06Felix06/Stecktec-EIC_GitHub/docs/Auslageblatt.pdf

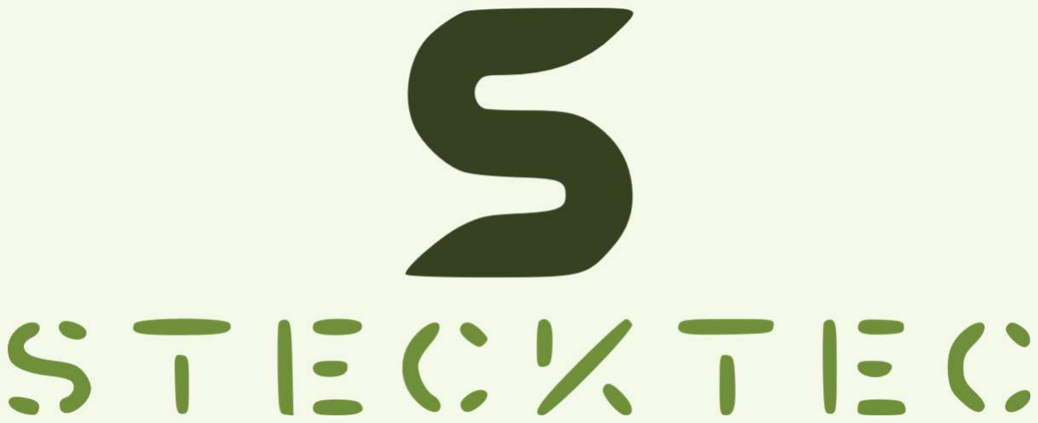
[picture p14: figure]

# Maturaprojekt 2025

### Felix Steck 5BEL – Elektronik

- Sensorbasiert: Misst Bodenfeuchte, Temperatur und Luftfeuchtigkeit
- Automatisiert: Steuert die Bewässerung gezielt nach Bedarf
- Mobile App: Einfache Steuerung und Anzeige per Smartphone
- Modular: Je nach Bedarf durch verschiedene Module erweiterbar

# Bewässerungssteuerung

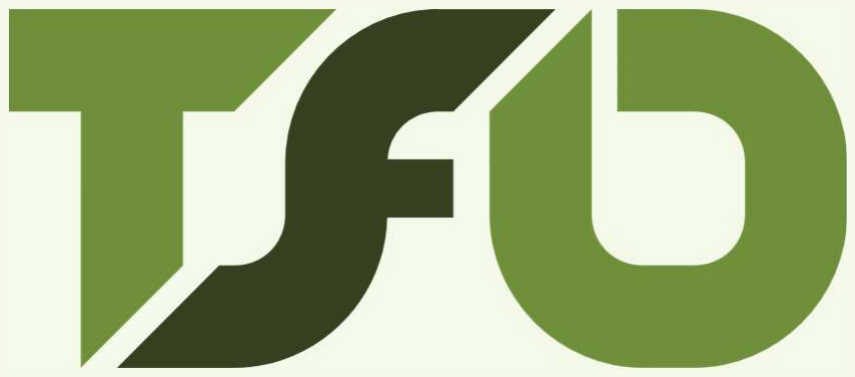
[picture p15: figure]
