06Felix06/Stecktec-EIC_GitHub/docs/projektmanagement/Blockschaltbild.pdf

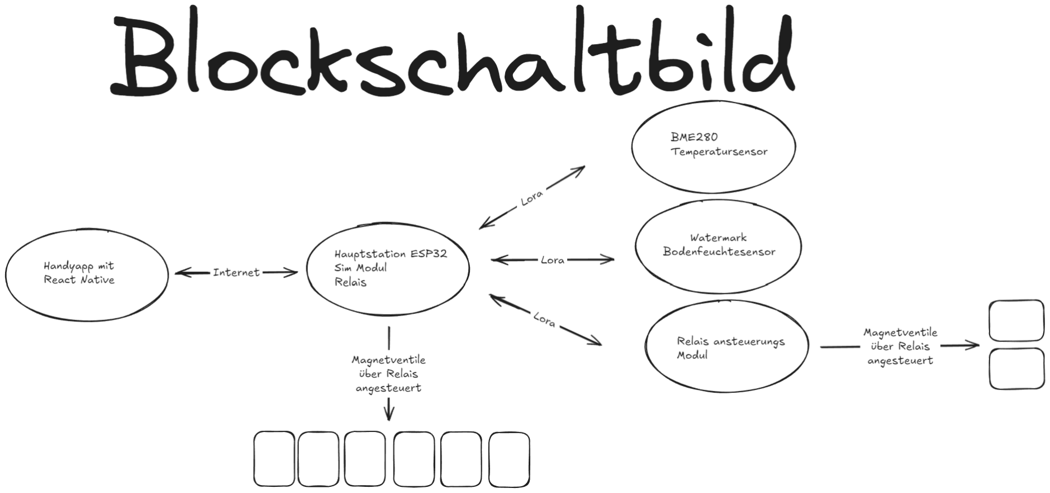
[picture p64: page 1]
