06Felix06/Stecktec-EIC_GitHub/hardware/01_Hauptplatine_V2/production/bom.csv

Designator | Footprint | Quantity | Value | LCSC Part #
Battery1 | BAT-TH_L77.0-W39.9_BH-18650-A1BJ021 | 1 | BH-18650-A1BJ021 | C20606804
C1, C10, C2, C4, C5, C6, C8, Cbyp1 | 0805 | 8 | 100nF
C3 | 0805 | 1 | 10µF
Ccomp1 | 0805 | 1 | 1.8nF
Ccomp2, Cfilt1 | 0805 | 2 | 33nF
Cin1, Cout1, Cout2 | CAP-TH_BD6.3-P2.50-D1.0-FD | 3 | 120µ | C442997
D1, D10, D11, D12, D13, D14, D15, D16, D17, D2, D3, D4, D5, D6, D7, D8 | SMA_L4.3-W2.5-LS5.0-RD | 16 | Diode | C727081
D30 | 0805 | 1 | kopplungLED
D31 | 0805 | 1 | PWR_LED
D9 | SMC_L7.1-W6.2-LS8.1-RD | 1 | B540C-13-F | C72264
J1 | PinSocket_1x07_P2.54mm_Vertical | 1 | LoraModule
J15 | PinHeader_1x02_P2.54mm_Vertical | 1 | Jumper_LED
J17 | PinSocket_1x03_P2.54mm_Vertical | 1 | Befestigung
J2 | PinHeader_2x04_P2.54mm_Vertical | 1 | Bootload
J20, J4 | PinSocket_1x12_P2.54mm_Vertical | 2 | Erweiterung_Ventile1
J3 | PinSocket_1x06_P2.54mm_Vertical | 1 | DS3231_RTC
J5 | PinSocket_1x07_P2.54mm_Vertical | 1 | Sim7000
J7 | PinSocket_1x06_P2.54mm_Vertical | 1 | USB_IN_Bat_volt
J8 | PinSocket_1x06_P2.54mm_Vertical | 1 | Bat_Solar_Vout
JP4, JP5, JP6 | SolderJumper-2_P1.3mm_Open_Pad1.0x1.5mm | 3 | SolderJumper_2_Open
L1 | IND-SMD_L6.6-W6.4 | 1 | XAL6030 | C19191693
R1, R6, R7, R8 | 0805 | 4 | 10k
R2, R3 | 0805 | 2 | 470k
R4, R5 | 0805 | 2 | 4.7k
RV_LED1, RV_LED2, Rfb1 | 0805 | 3 | 1k
Rcomp1 | 0805 | 1 | 2.94k
Reset1 | SW-SMD_4P-L6.2-W6.2-P4.50-LS8.6 | 1 | Reset | C2909692
Rfadj1 | 0805 | 1 | 26.7k
Rfb2 | 0805 | 1 | 8.45k
Rfilt1 | 0805 | 1 | 100
Rsense1 | 0805 | 1 | 5mΩ
Solar1 | CONN-TH_B2B-PH-K-S | 1 | B2B-PH-K-S(LF)(SN) | C131337
TP1 | TPSteckFelix | 1 | tp_Bat+
TP2 | TPSteckFelix | 1 | tp_Solar+
TP3 | TPSteckFelix | 1 | tp_+5V
TP4 | TPSteckFelix | 1 | tp_+3V3
TP5 | TPSteckFelix | 1 | tpGND
TP6 | TPSteckFelix | 1 | tp_+12V
U1 | TQFP-32_L7.0-W7.0-P0.80-LS9.0-BL | 1 | ATMEGA328P-AU | C14877
U10, U2 | HSOP-20_L15.9-W11.0-P1.27-LS14.2-BL-EP | 2 | XL298P | C17179540
U11 | SOIC-8_L5.0-W4.0-P1.27-LS6.0-BL | 1 | LM358
U12 | SSOP-28_L10.2-W5.3-P0.65-LS7.8-BL | 1 | MCP23S17-E/SS | C148009
U3 | CONN-TH_B5B-PH-K-S-LF-SN | 1 | Vent1 | C157993
U4 | VSSOP-8_L3.0-W3.0-P0.65-LS5.0-BL | 1 | LM3478MM | C9404
U5 | SOP-8_L4.9-W3.9-P1.27-LS6.0-BL | 1 | IRF7807 | C5350865
U6 | CONN-TH_B5B-PH-K-S-LF-SN | 1 | Vent2 | C157993
U7 | CONN-TH_B5B-PH-K-S-LF-SN | 1 | Vent3 | C157993
U8 | SOIC-16_L9.9-W3.9-P1.27-LS6.0-BL | 1 | CD4052B | C5356105
U9 | CONN-TH_B5B-PH-K-S-LF-SN | 1 | Vent4 | C157993
X1 | OSC-SMD_3P-L3.2-W1.3-P1.20-L | 1 | CSTNE16M0V53Z000R0 | C783275
