06Felix06/Stecktec-EIC_GitHub/hardware/03_Magnetventilsteuerung/production/bom.csv

Designator | Footprint | Quantity | Value | LCSC Part #
C1, Cbyp1 | 0805 | 2 | 100nF
CN1 | CONN-TH_B3B-PH-K-S | 1 | SENS_Vent1 | C131339
CN2 | CONN-TH_B3B-PH-K-S | 1 | SENS_Vent2 | C131339
Ccomp1, Cfilt1 | 0805 | 2 | 33nF
Ccomp2 | 0805 | 1 | 1.8nF
Cin1, Cout1, Cout2 | CAP-TH_BD6.3-P2.50-D1.0-FD | 3 | 120µ | C442997
D1, D2, D3, D4, D5, D6, D7, D8 | SMA_L4.3-W2.5-LS5.0-RD | 8 | 1N4007 | C727081
D9 | SMC_L7.1-W6.2-LS8.1-RD | 1 | B540C-13-F | C72264
J1, J2 | PinHeader_1x10_P2.54mm_Vertical | 2 | PINHD_1x10_Male
L1 | IND-SMD_L6.6-W6.4 | 1 | XAL6030 | C19191693
Rcomp1 | 0805 | 1 | 2.94k
Rfadj1 | 0805 | 1 | 26.7k
Rfb1 | 0805 | 1 | 1k
Rfb2 | 0805 | 1 | 8.45k
Rfilt1 | 0805 | 1 | 100
Rsense1 | 0805 | 1 | 5mΩ
U1 | HSOP-20_L15.9-W11.0-P1.27-LS14.2-BL-EP | 1 | XL298P | C17179540
U2 | CONN-TH_2P-P5.00_MX127-5.0-02P-GN01-CU-Y-A | 1 | Vent1 | C5188440
U3 | CONN-TH_2P-P5.00_MX127-5.0-02P-GN01-CU-Y-A | 1 | Vent2 | C5188440
U4 | VSSOP-8_L3.0-W3.0-P0.65-LS5.0-BL | 1 | LM3478MM | C9404
U5 | SOP-8_L4.9-W3.9-P1.27-LS6.0-BL | 1 | IRF7807 | C5350865
