06Felix06/Stecktec-EIC_GitHub/hardware/04_Solarversorgung_V2/production/bom.csv

Designator | Footprint | Quantity | Value | LCSC Part #
C1, C4, C6 | 0805 | 3 | 10µ
C2, C5 | 0805 | 2 | 100n
C3 | 0805 | 1 | 22µ
C7 | 0805 | 1 | 47µ
C8 | 0805 | 1 | 4.7µF
C9 | 0805 | 1 | 22µF
D1 | SMA_L4.3-W2.6-LS5.2-RD | 1 | SS34_C8678 | C8678
D2 | 0805 | 1 | STDBY
D4 | 0805 | 1 | CHRG
J1 | PinHeader_1x02_P2.54mm_Vertical | 1 | LED_JMP
J5 | PinHeader_1x06_P2.54mm_Vertical | 1 | USB_IN_Bat_volt_3.3
J7 | PinHeader_1x06_P2.54mm_Vertical | 1 | Bat_Solar_Vout
L1 | IND-SMD_L4.5-W4.1_SL0420 | 1 | SL0420-100M | C22463809
L2 | IND-SMD_L7.2-W6.6_GPSR07X0 | 1 | CYA0630-2.2UH | C5189746
R1, R2 | 0805 | 2 | 1k
R3 | 0805 | 1 | 2k
R4 | 0805 | 1 | 300mΩ
R5 | RES-ADJ-SMD_VG039NCH | 1 | 200k | C128558
SW1 | SW-SMD_MK-12C02-G025 | 1 | MK-12C02-G025 | C778186
U1 | ESOP-8_L4.9-W3.9-P1.27-LS6.0-BL-EP | 1 | TP5400 | C2891434
U2 | SOT-23-5_L3.0-W1.7-P0.95-LS2.8-BR | 1 | TLV62569DBVR | C141836
