06Felix06/Stecktec-EIC_GitHub/hardware/3D-Gehaeuse/Programmiergeraet/V1DeckelCase.stl

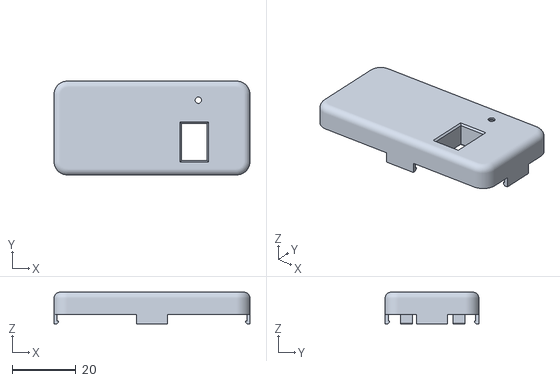
[picture p65: CAD file, 2026-11-07]
hardware/3D-Gehaeuse/Programmiergeraet/V1DeckelCase.stl
61.4 x 29.4 x 10.0
