06Felix06/Stecktec-EIC_GitHub/hardware/3D-Gehaeuse/V2_GehäuseSensor_Body.stl

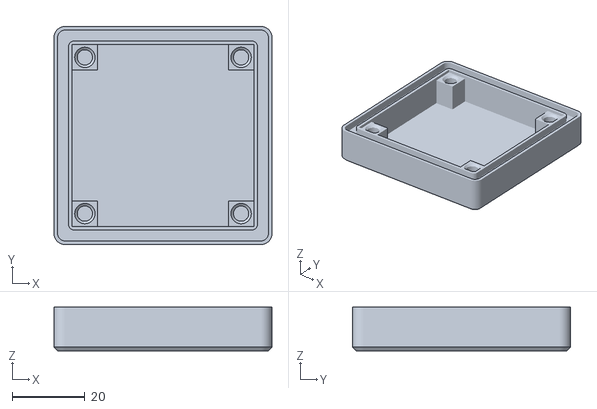
[picture p66: CAD file, 2026-11-07]
hardware/3D-Gehaeuse/V2_GehäuseSensor_Body.stl
60.0 x 60.0 x 12.0
