06Felix06/Stecktec-EIC_GitHub/hardware/3D-Gehaeuse/Programmiergeraet/V2Reset Drucker.stl

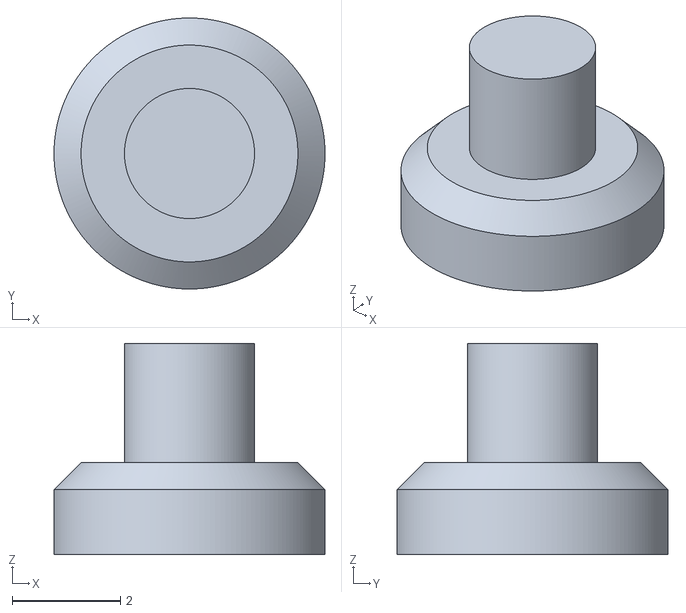
[picture p67: CAD file, 2026-11-07]
hardware/3D-Gehaeuse/Programmiergeraet/V2Reset Drucker.stl
5.00 x 5.00 x 3.90
