06Felix06/Stecktec-EIC_GitHub/hardware/3D-Gehaeuse/Programmiergeraet/V1BodenCase.stl

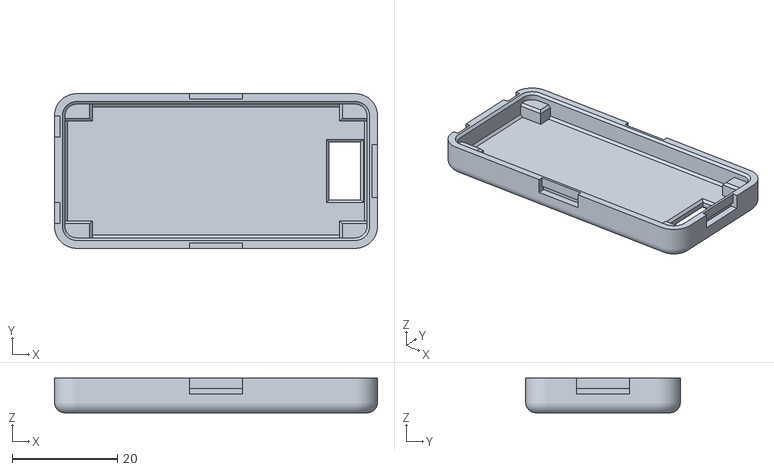
[picture p68: CAD file, 2026-11-07]
hardware/3D-Gehaeuse/Programmiergeraet/V1BodenCase.stl
61.4 x 29.4 x 6.60
