06Felix06/Stecktec-EIC_GitHub/hardware/3D-Gehaeuse/V1_GehäuseSensor_Deckel.stl

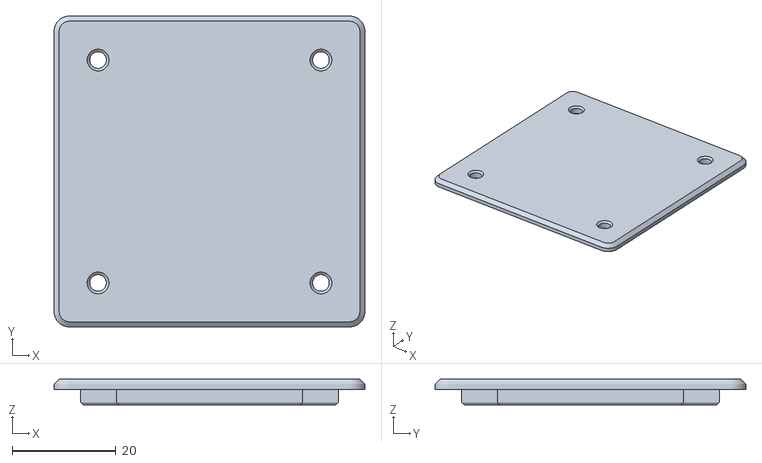
[picture p69: CAD file, 2026-11-07]
hardware/3D-Gehaeuse/V1_GehäuseSensor_Deckel.stl
60.0 x 60.0 x 5.00
