06Felix06/Stecktec-EIC_GitHub/hardware/3D-Gehaeuse/Programmiergeraet/V1Reset Drucker.stl

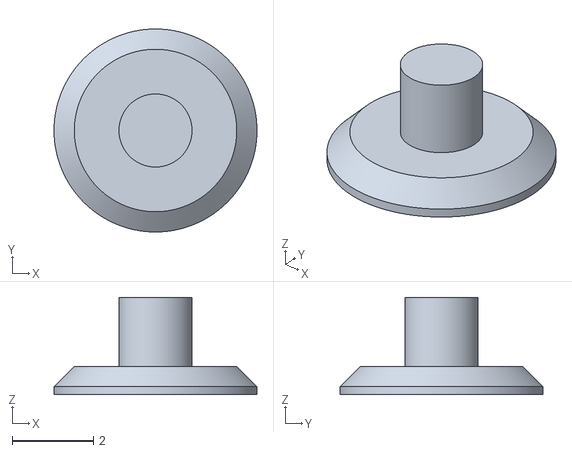
[picture p70: CAD file, 2026-11-07]
hardware/3D-Gehaeuse/Programmiergeraet/V1Reset Drucker.stl
5.00 x 5.00 x 2.40
