06Felix06/Stecktec-EIC_GitHub/(list of files, cad)

Other CAD files:
hardware/3D-Gehaeuse/V1_GehäuseSensor_Body.stl
