06Felix06/Stecktec-EIC_GitHub/docs/projektmanagement/AufbauPlatinen.pdf

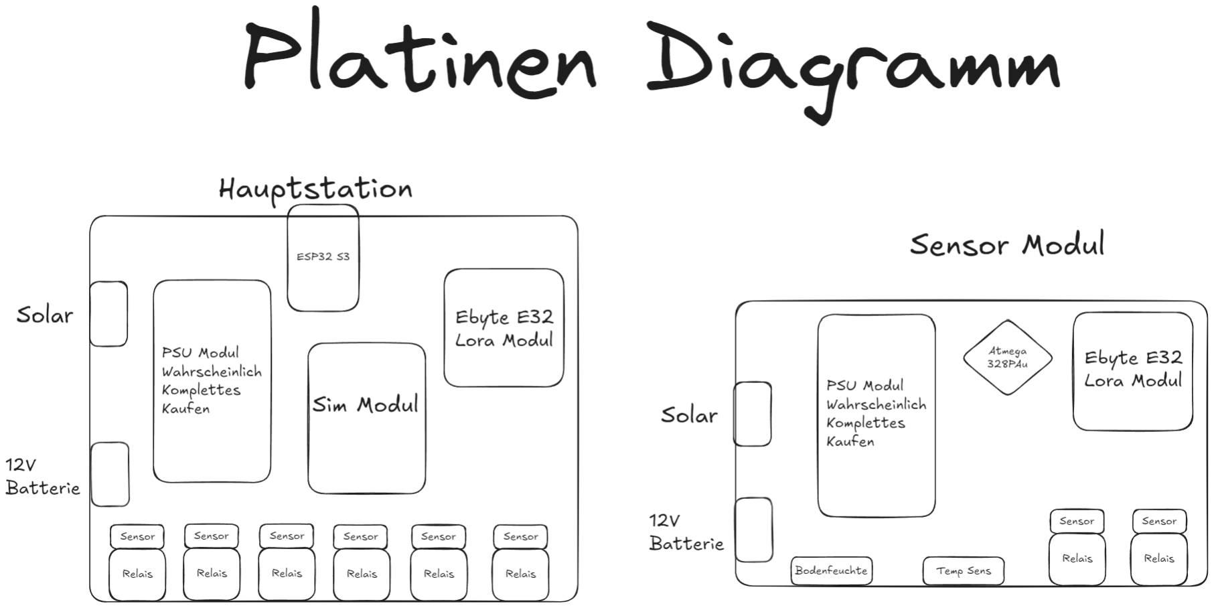
[picture p71: page 1]
