06Felix06/Stecktec-EIC_GitHub/hardware/01_Hauptplatine_V2/HauptplatineEIC_V2.pdf

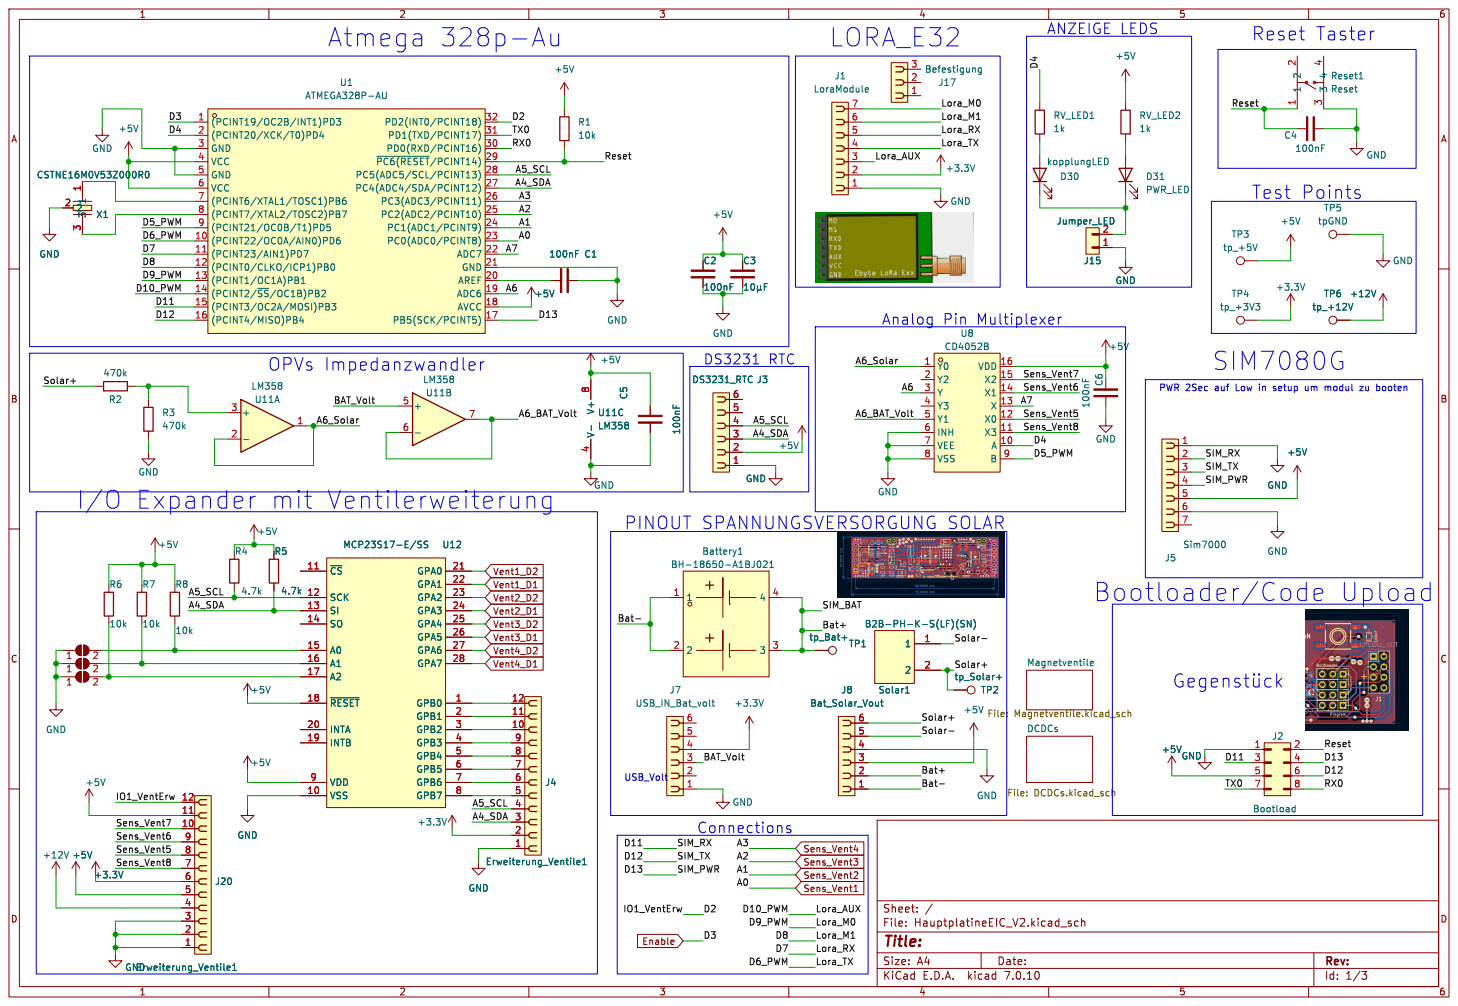
[picture p72: page 1]

PWR 2Sec auf Low in setup um modul zu booten Atmega 328p-Au

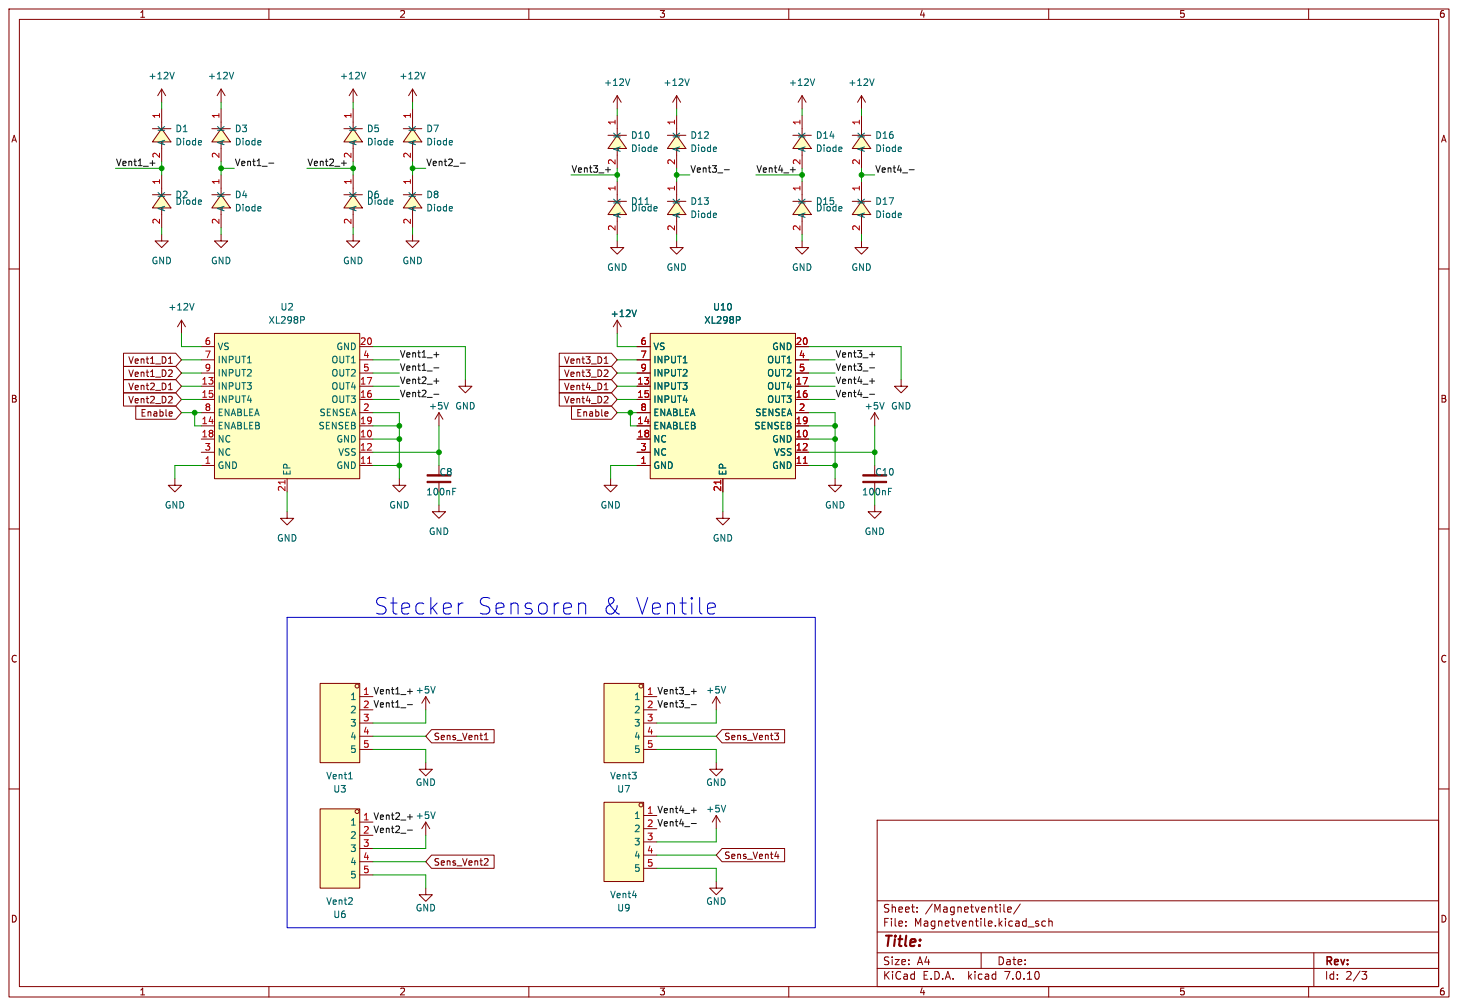
[picture p73: page 2]

2 D5 Diode GND GND 1 GND 10 GND 11 VSS 12

Id: 2/3 Title: File: Magnetventile.kicad_sch Sheet: /Magnetventile/ GND

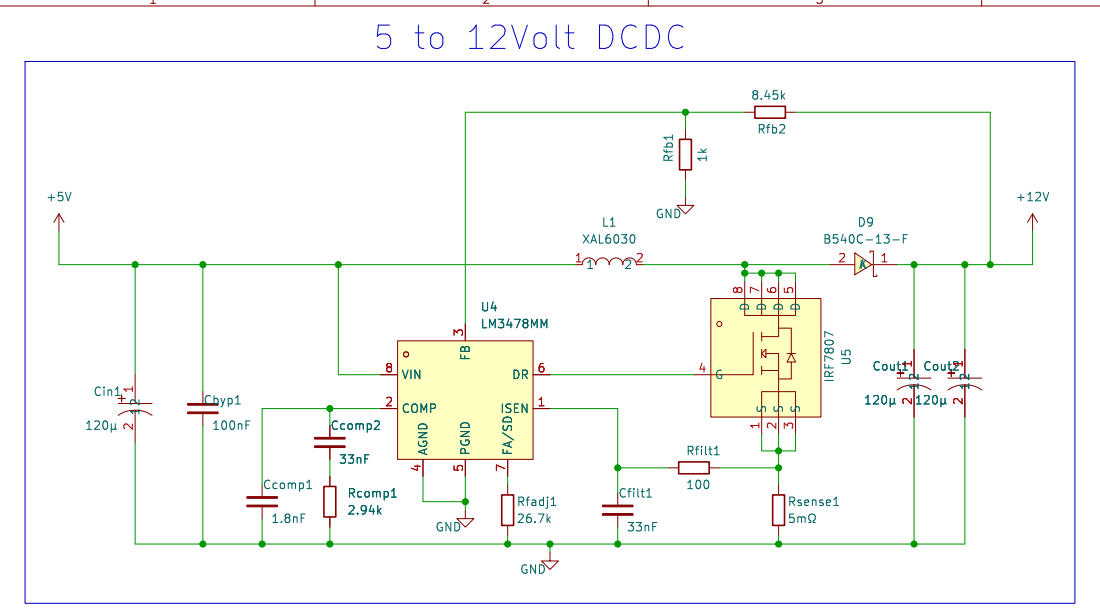
[picture p74: page 3]

Id: 3/3 Title: File: DCDCs.kicad_sch Sheet: /DCDCs/
