06Felix06/Stecktec-EIC_GitHub/hardware/02_Sensorplatine/Sensor_Baseplatine_ohneUSB__Assembly.pdf

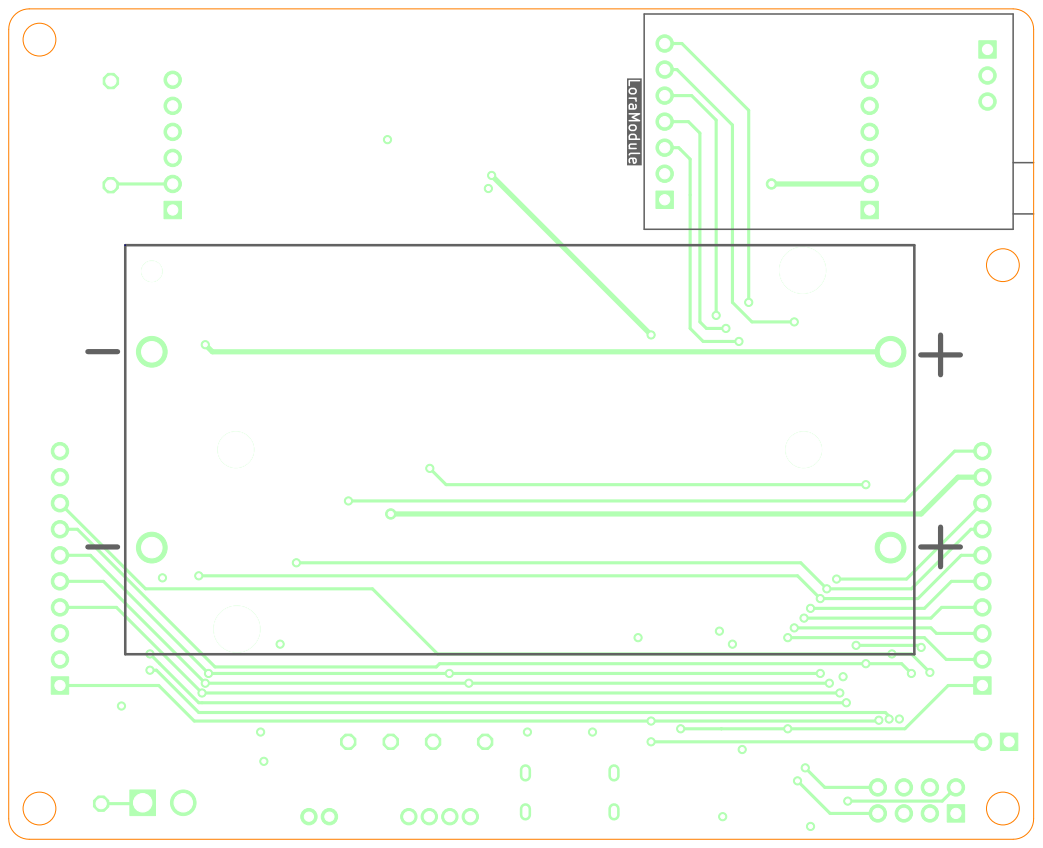
[picture p75: page 1]
D Date: KiCad; kicad; 7.0.10 Size: A4; Rev:

Id: 1/1 Title: File: Sensor_Baseplatine_ohneUSB.kicad_pcb Sheet:

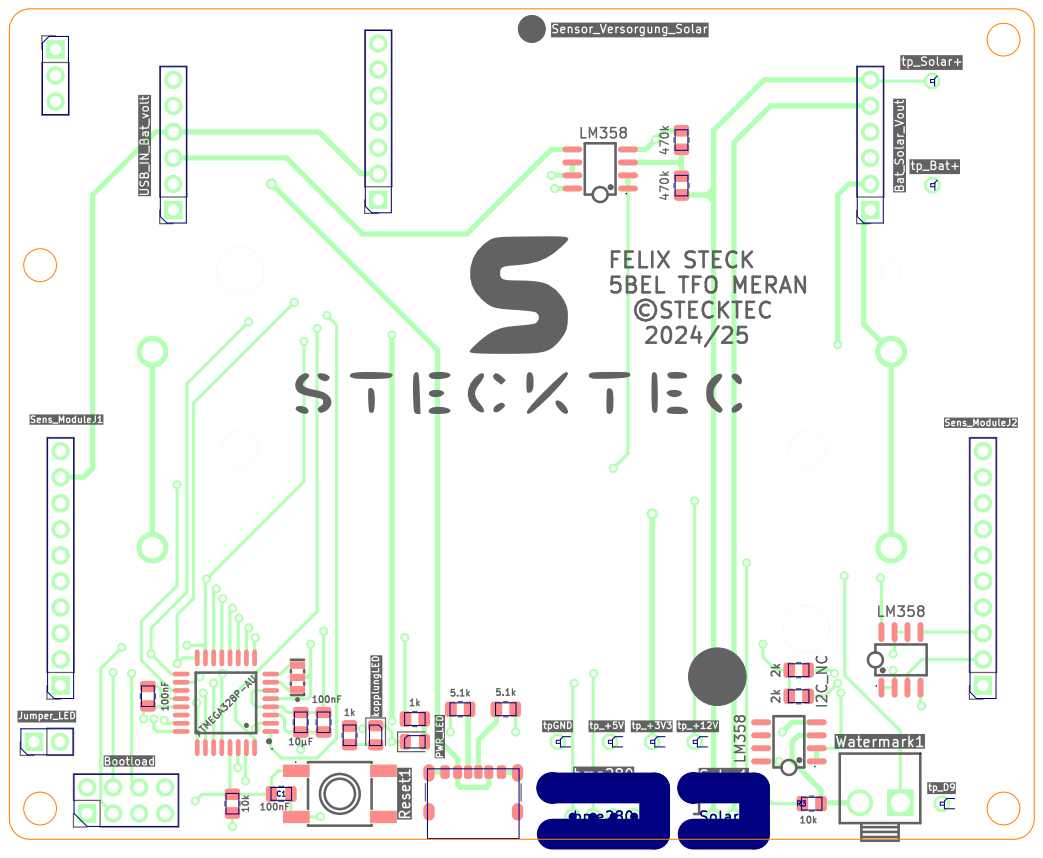
[picture p76: page 2]
FELIX STECK; 5BEL TFO; MERAN; I2C_NC ⁴⁷⁰k 100nF; LM358 ⁴⁷⁰k; ATMEGA328P-AU; LM³⁵⁸; D Date: KiCad; kicad; 7.0.10 Size: A4; Rev:; Id: 1/1 Title: File: Sensor_Baseplatine_ohneUSB.kicad_pcb Sheet:; bme280; Solar1
