06Felix06/Stecktec-EIC_GitHub/hardware/05_Programmiergeraet/Atmega_Programmer.pdf

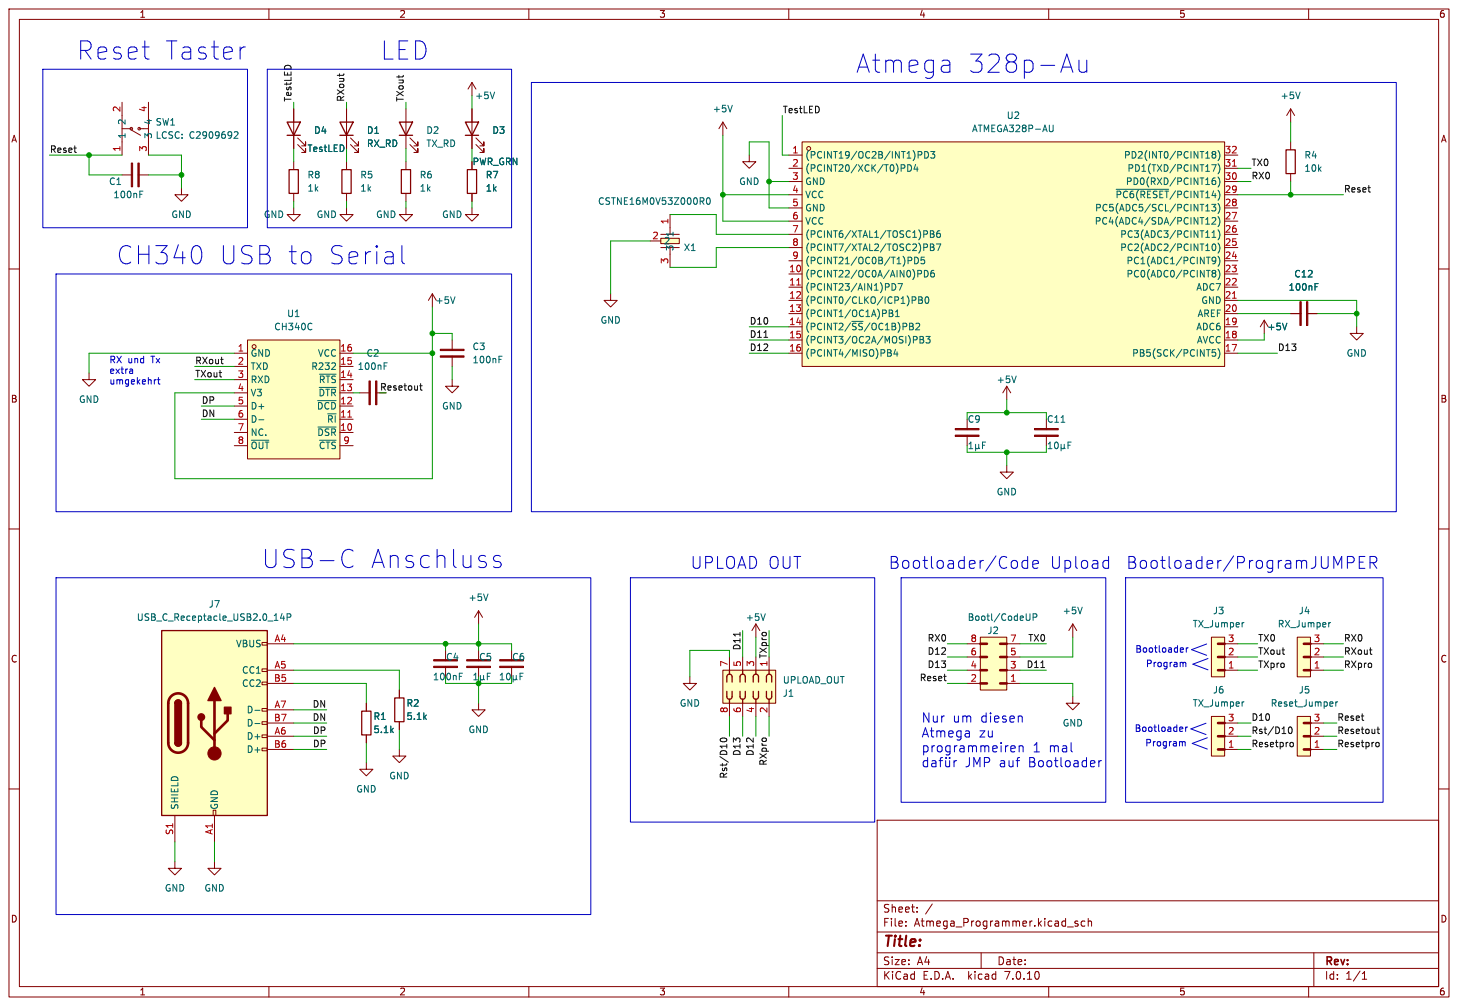
[picture p77: page 1]

RX und Tx extra

Id: 1/1 Title: File: Atmega_Programmer.kicad_sch Sheet: / R1

Nur um diesen
Atmega zu
þÿdafür JMP auf Bootloader
