06Felix06/Stecktec-EIC_GitHub/hardware/05_Programmiergeraet/Atmega_Programmer__Assembly.pdf

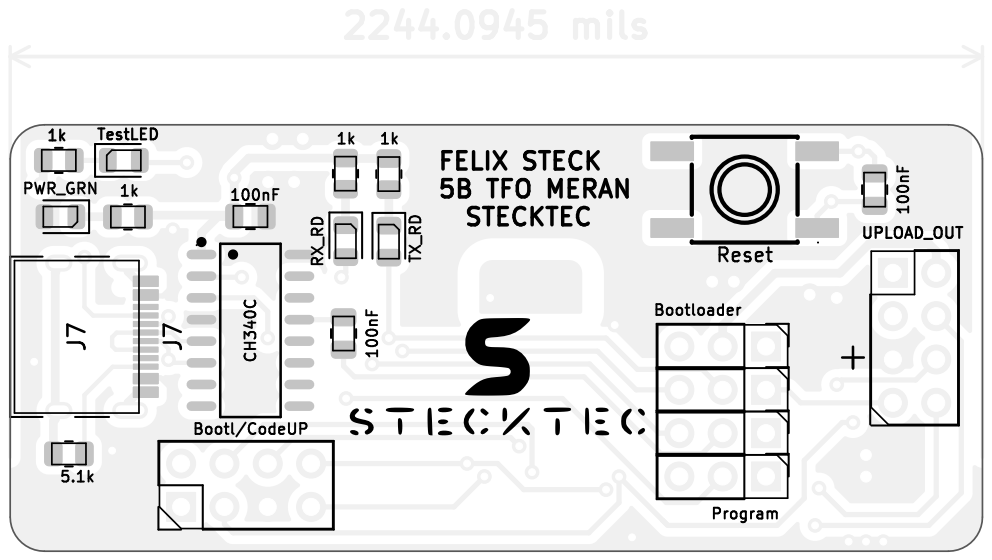
[picture p78: page 1]
mils; FELIX STECK 5B TFO MERAN STECKTEC; Program; Bootloader 1k; UPLOAD_OUT; Reset PWR_GRN; Bootl/CodeUP; TestLED; CH³⁴⁰C; D Date: KiCad; kicad; 7.0.10 Size: A4; Rev:

Id: 1/1 Title: File: Atmega_Programmer.kicad_pcb Sheet: J7

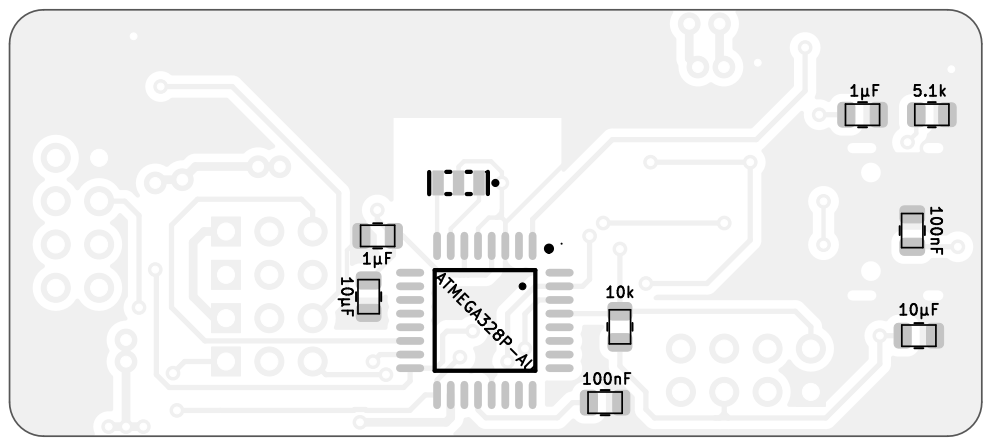
[picture p79: page 2]
1µF ATMEGA328P-AU; 1µF 100nF ¹⁰µF; D Date: KiCad; kicad; 7.0.10 Size: A4; Rev:

Id: 1/1 Title: File: Atmega_Programmer.kicad_pcb Sheet:
