06Felix06/Stecktec-EIC_GitHub/hardware/archiv_V1/Hauptplatine_V1_ESP32/HauptplatineEIC.pdf

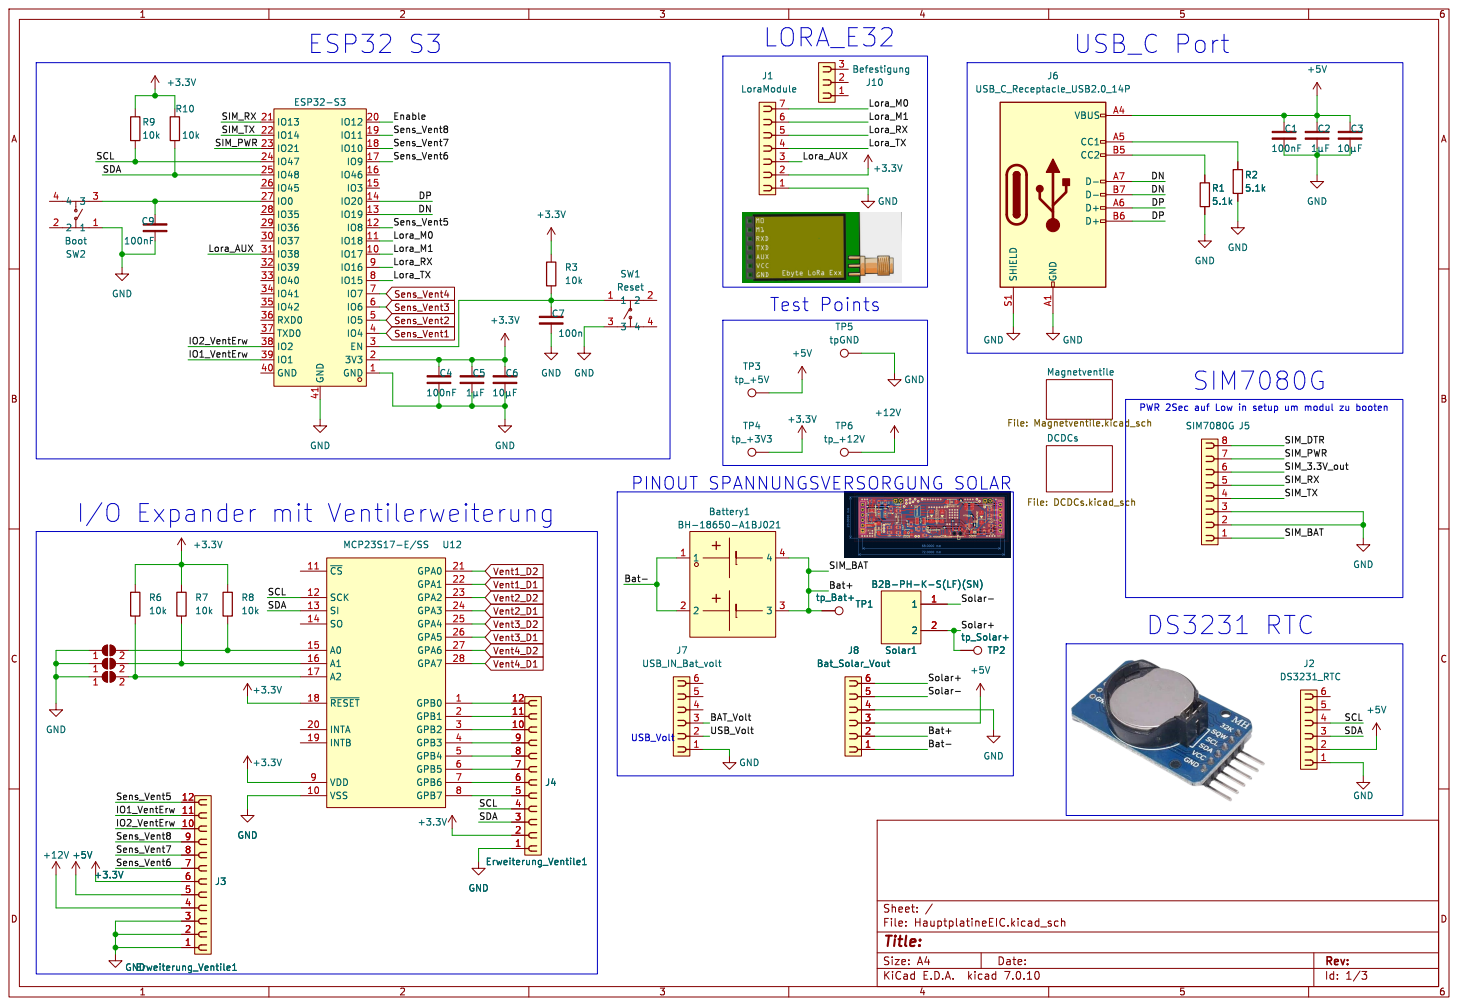
[picture p80: page 1]

DCDCs File: DCDCs.kicad_sch Magnetventile File: Magnetventile.kicad_sch +5V

PWR 2Sec auf Low in setup um modul zu booten SIM7080G

Id: 1/3 Title: File: HauptplatineEIC.kicad_sch Sheet: /


2 D5 Diode GND GND 1 GND 10 GND 11 VSS 12

Id: 2/3 Title: File: Magnetventile.kicad_sch Sheet: /Magnetventile/ GND

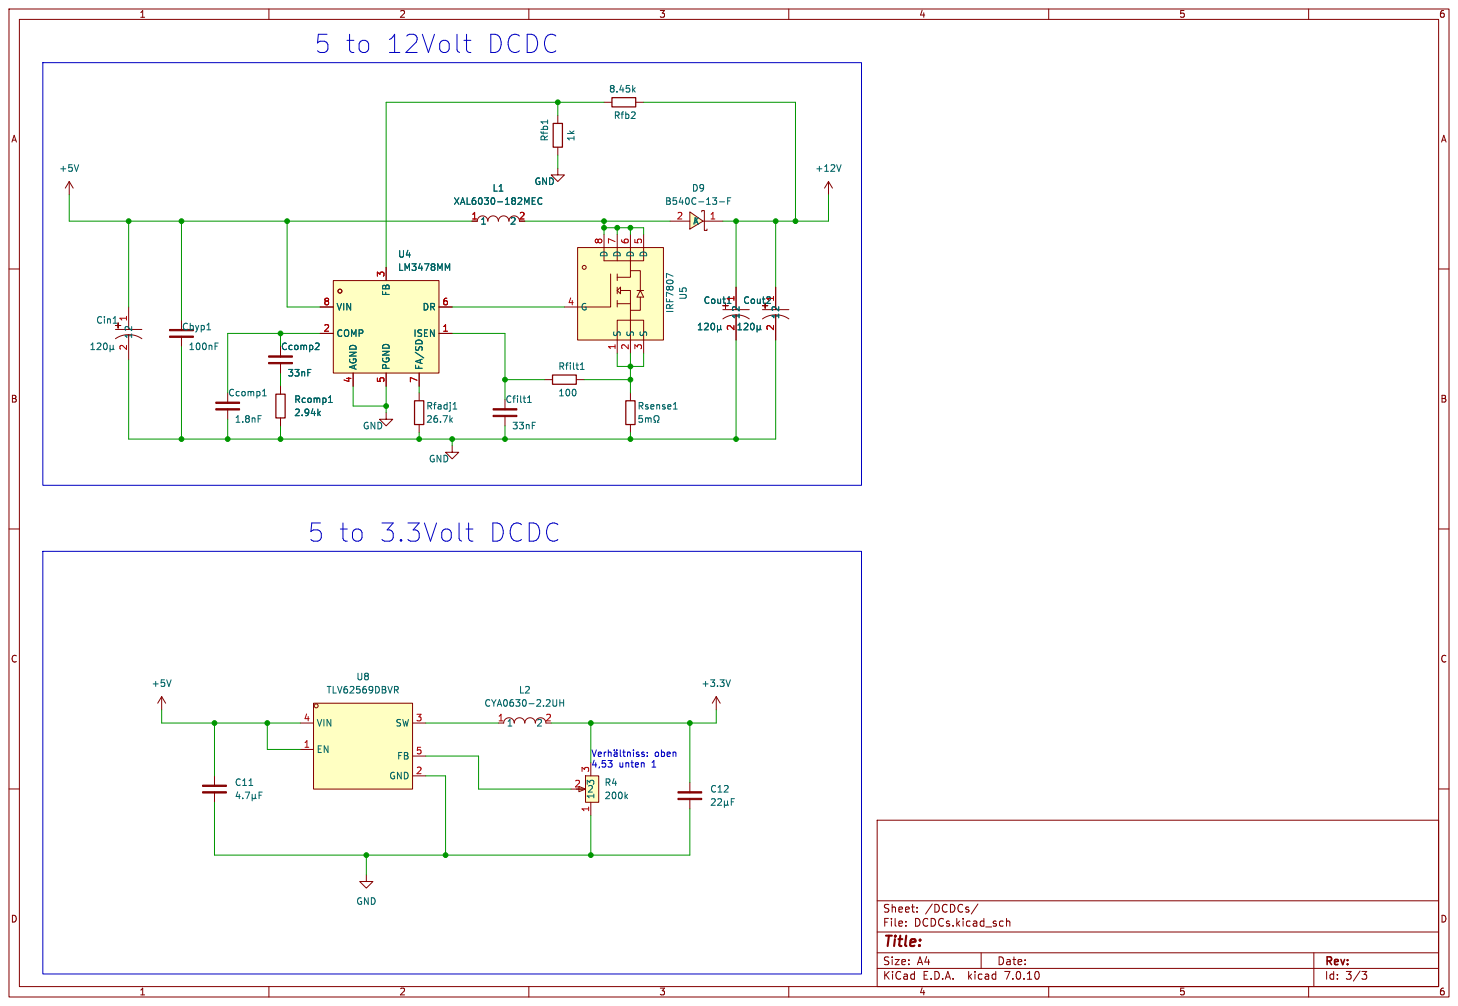
[picture p81: page 3]

Id: 3/3 Title: File: DCDCs.kicad_sch Sheet: /DCDCs/ GND
