06Felix06/Stecktec-EIC_GitHub/hardware/archiv_V1/Solarversorgung_V1/Sensor_Versorgung_Solar.pdf

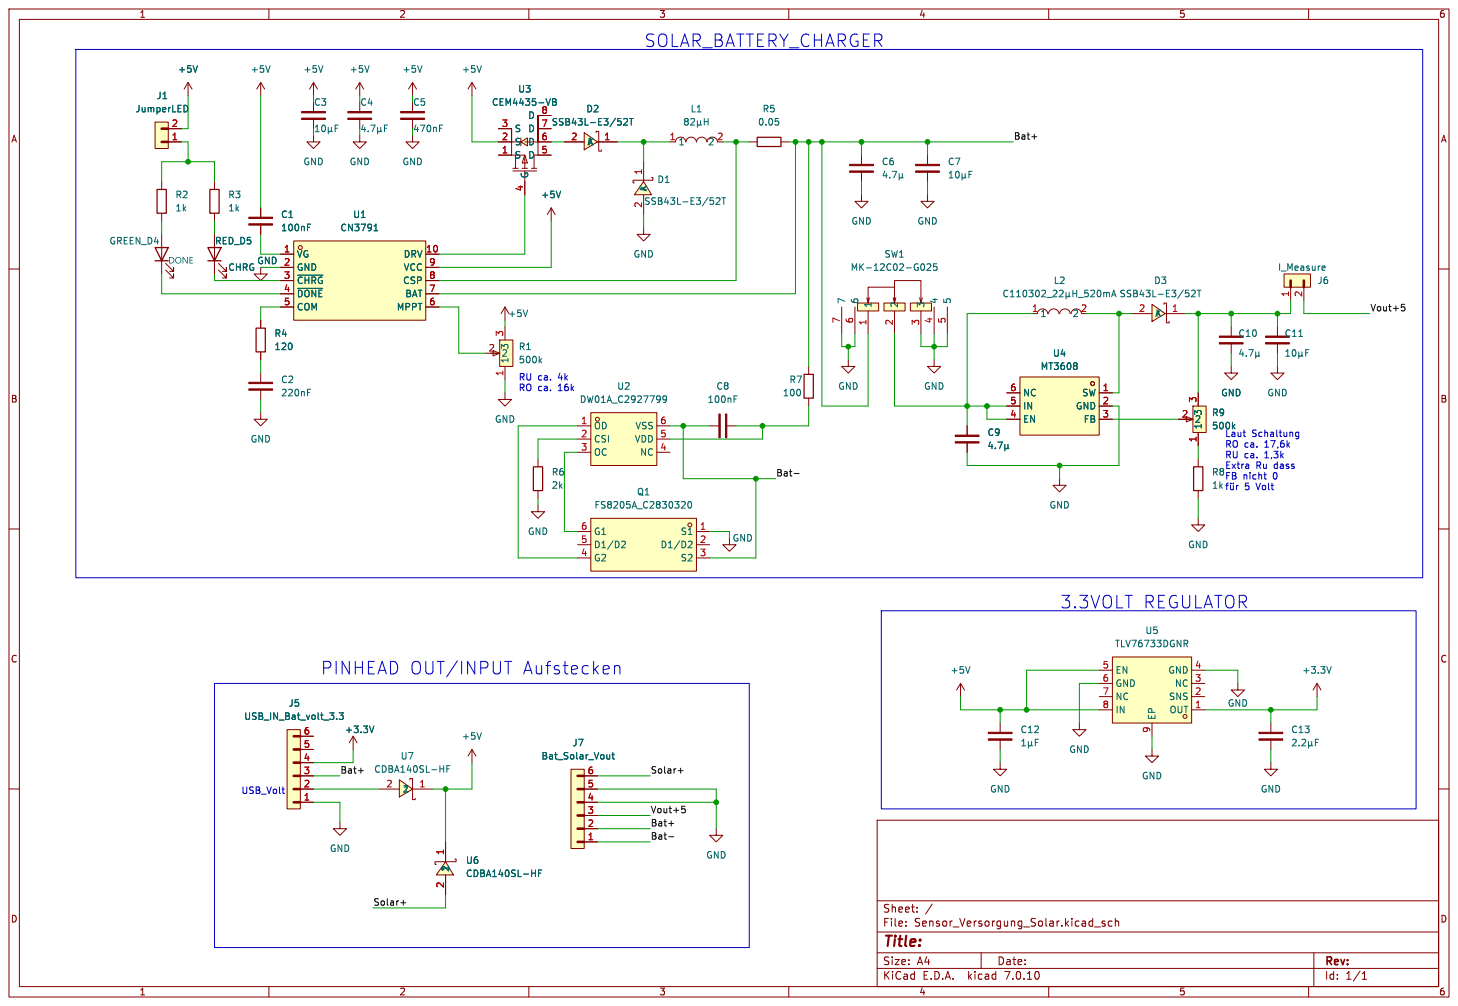
[picture p82: page 1]

Id: 1/1 Title: File: Sensor_Versorgung_Solar.kicad_sch Sheet: /
