06Felix06/Stecktec-EIC_GitHub/hardware/04_Solarversorgung_V2/V2_Sensor_Versorgung_Solar.kicad_pcb

## KiCad design hardware/04_Solarversorgung_V2/V2_Sensor_Versorgung_Solar.kicad_pcb (2026-11-07)

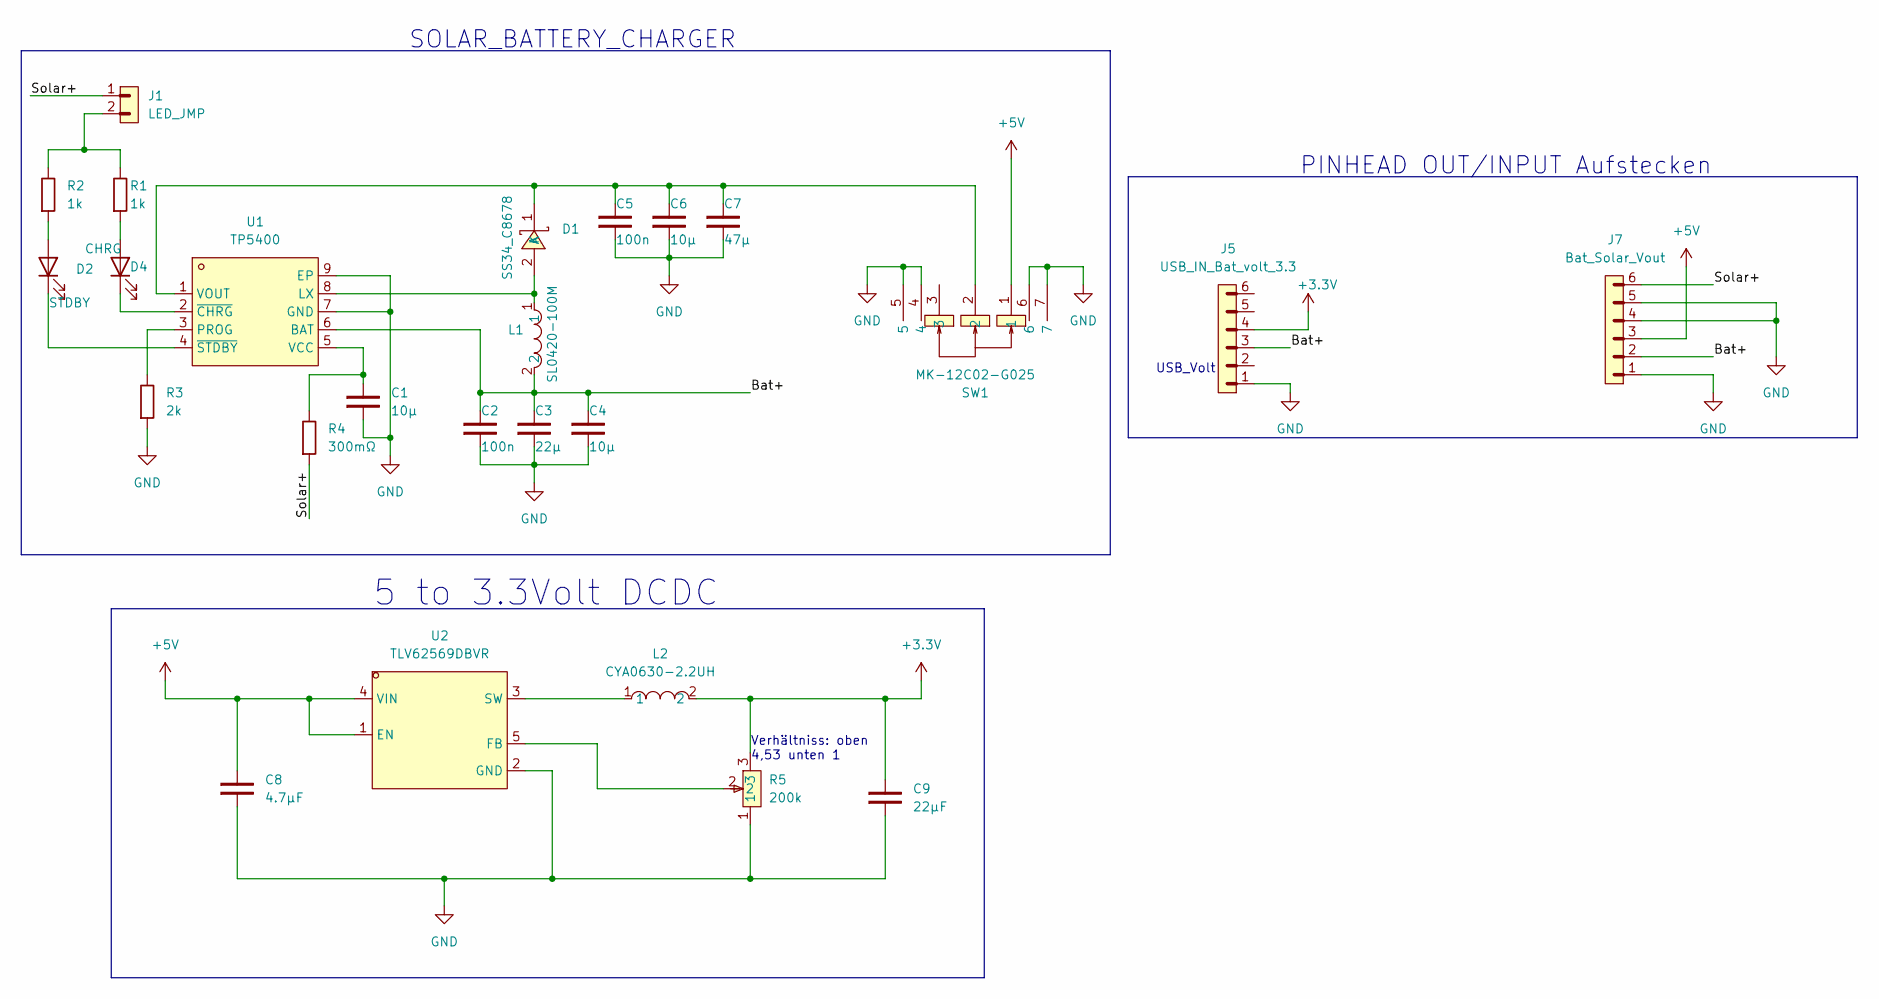
[picture p83: schematic V2_Sensor_Versorgung_Solar.kicad_sch]

Parts:
C1, C4, C6: 10µ; C_0805_2012Metric
C2, C5: 100n; C_0805_2012Metric
C3: 22µ; C_0805_2012Metric
C7: 47µ; C_0805_2012Metric
C8: 4.7µF; C_0805_2012Metric
C9: 22µF; C_0805_2012Metric
D1: SS34_C8678; SMA_L4.3-W2.6-LS5.2-RD; LCSC Part C8678
D2: STDBY; LED_0805_2012Metric
D4: CHRG; LED_0805_2012Metric
J1: LED_JMP; PinHeader_1x02_P2.54mm_Vertical
J5: USB_IN_Bat_volt_3.3; PinHeader_1x06_P2.54mm_Vertical
J7: Bat_Solar_Vout; PinHeader_1x06_P2.54mm_Vertical
L1: SL0420-100M; IND-SMD_L4.5-W4.1_SL0420; LCSC Part C22463809
L2: CYA0630-2.2UH; IND-SMD_L7.2-W6.6_GPSR07X0; LCSC Part C5189746
R1, R2: 1k; R_0805_2012Metric
R3: 2k; R_0805_2012Metric
R4: 300mΩ; R_0805_2012Metric
R5: 200k; RES-ADJ-SMD_VG039NCH; LCSC Part C128558
SW1: MK-12C02-G025; SW-SMD_MK-12C02-G025; LCSC Part C778186
U1: TP5400; ESOP-8_L4.9-W3.9-P1.27-LS6.0-BL-EP; LCSC Part C2891434
U2: TLV62569DBVR; SOT-23-5_L3.0-W1.7-P0.95-LS2.8-BR; LCSC Part C141836

Connections:
+3.3V: C9.2, J5.4, L2.2, R5.3
+5V: C8.2, J7.3, SW1.1, U2.1 (EN), U2.4 (VIN)
/Bat+: C2.2, C3.2, C4.2, J5.3, J7.2, L1.2, U1.6 (BAT)
/Solar+: J1.1, J7.6, R4.1
GND: C1.1, C2.1, C3.1, C4.1, C5.1, C6.1, C7.1, C8.1, C9.1, J5.1, J7.1, J7.4, J7.5, R3.1, R5.1, SW1.4, SW1.5, SW1.6, SW1.7, U1.7 (GND), U1.9 (EP), U2.2 (GND)
unnamed: D1.2 (A), L1.1, U1.8 (LX)
unnamed: C5.2, C6.2, C7.2, D1.1 (K), SW1.2, U1.1 (VOUT)
unnamed: D2.2 (A), R2.1
unnamed: D2.1 (K), U1.4 (~STDBY)
unnamed: D4.2 (A), R1.1
unnamed: D4.1 (K), U1.2 (~CHRG)
unnamed: J1.2, R1.2, R2.2
unnamed: R3.2, U1.3 (PROG)
unnamed: C1.2, R4.2, U1.5 (VCC)
unnamed: R5.2, U2.5 (FB)
unnamed: L2.1, U2.3 (SW)

Notes on the sheet:
PINHEAD OUT/INPUT Aufstecken
SOLAR_BATTERY_CHARGER
5 to 3.3Volt DCDC
USB_Volt
Verhältniss: oben 4,53 unten 1

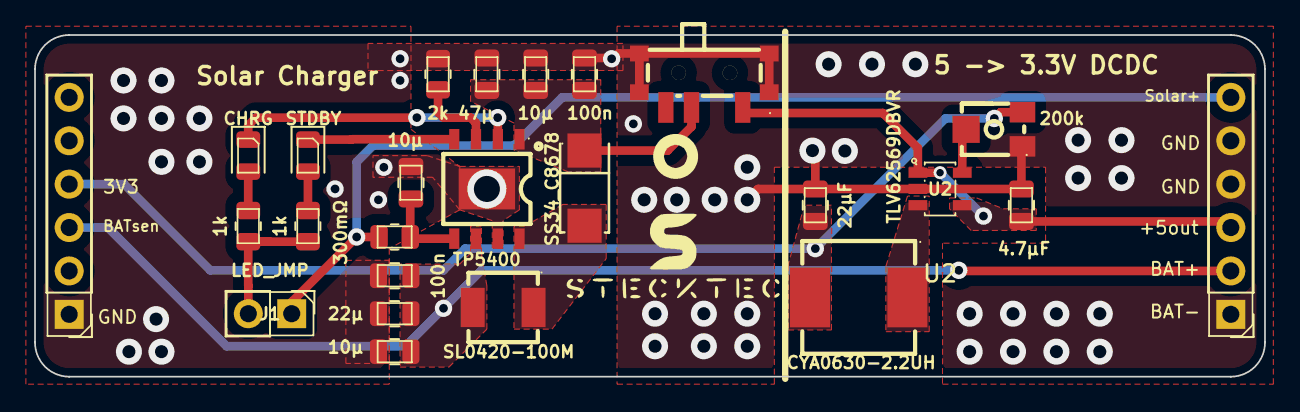
[picture p84: board V2_Sensor_Versorgung_Solar.kicad_pcb from above]

Board: 2 copper layers, 72.0 x 20.0 mm, 25 parts (0 on the bottom side), 16 nets.
