06Felix06/Stecktec-EIC_GitHub/hardware/05_Programmiergeraet/Atmega_Programmer.kicad_pcb

## KiCad design hardware/05_Programmiergeraet/Atmega_Programmer.kicad_pcb (2026-11-07)

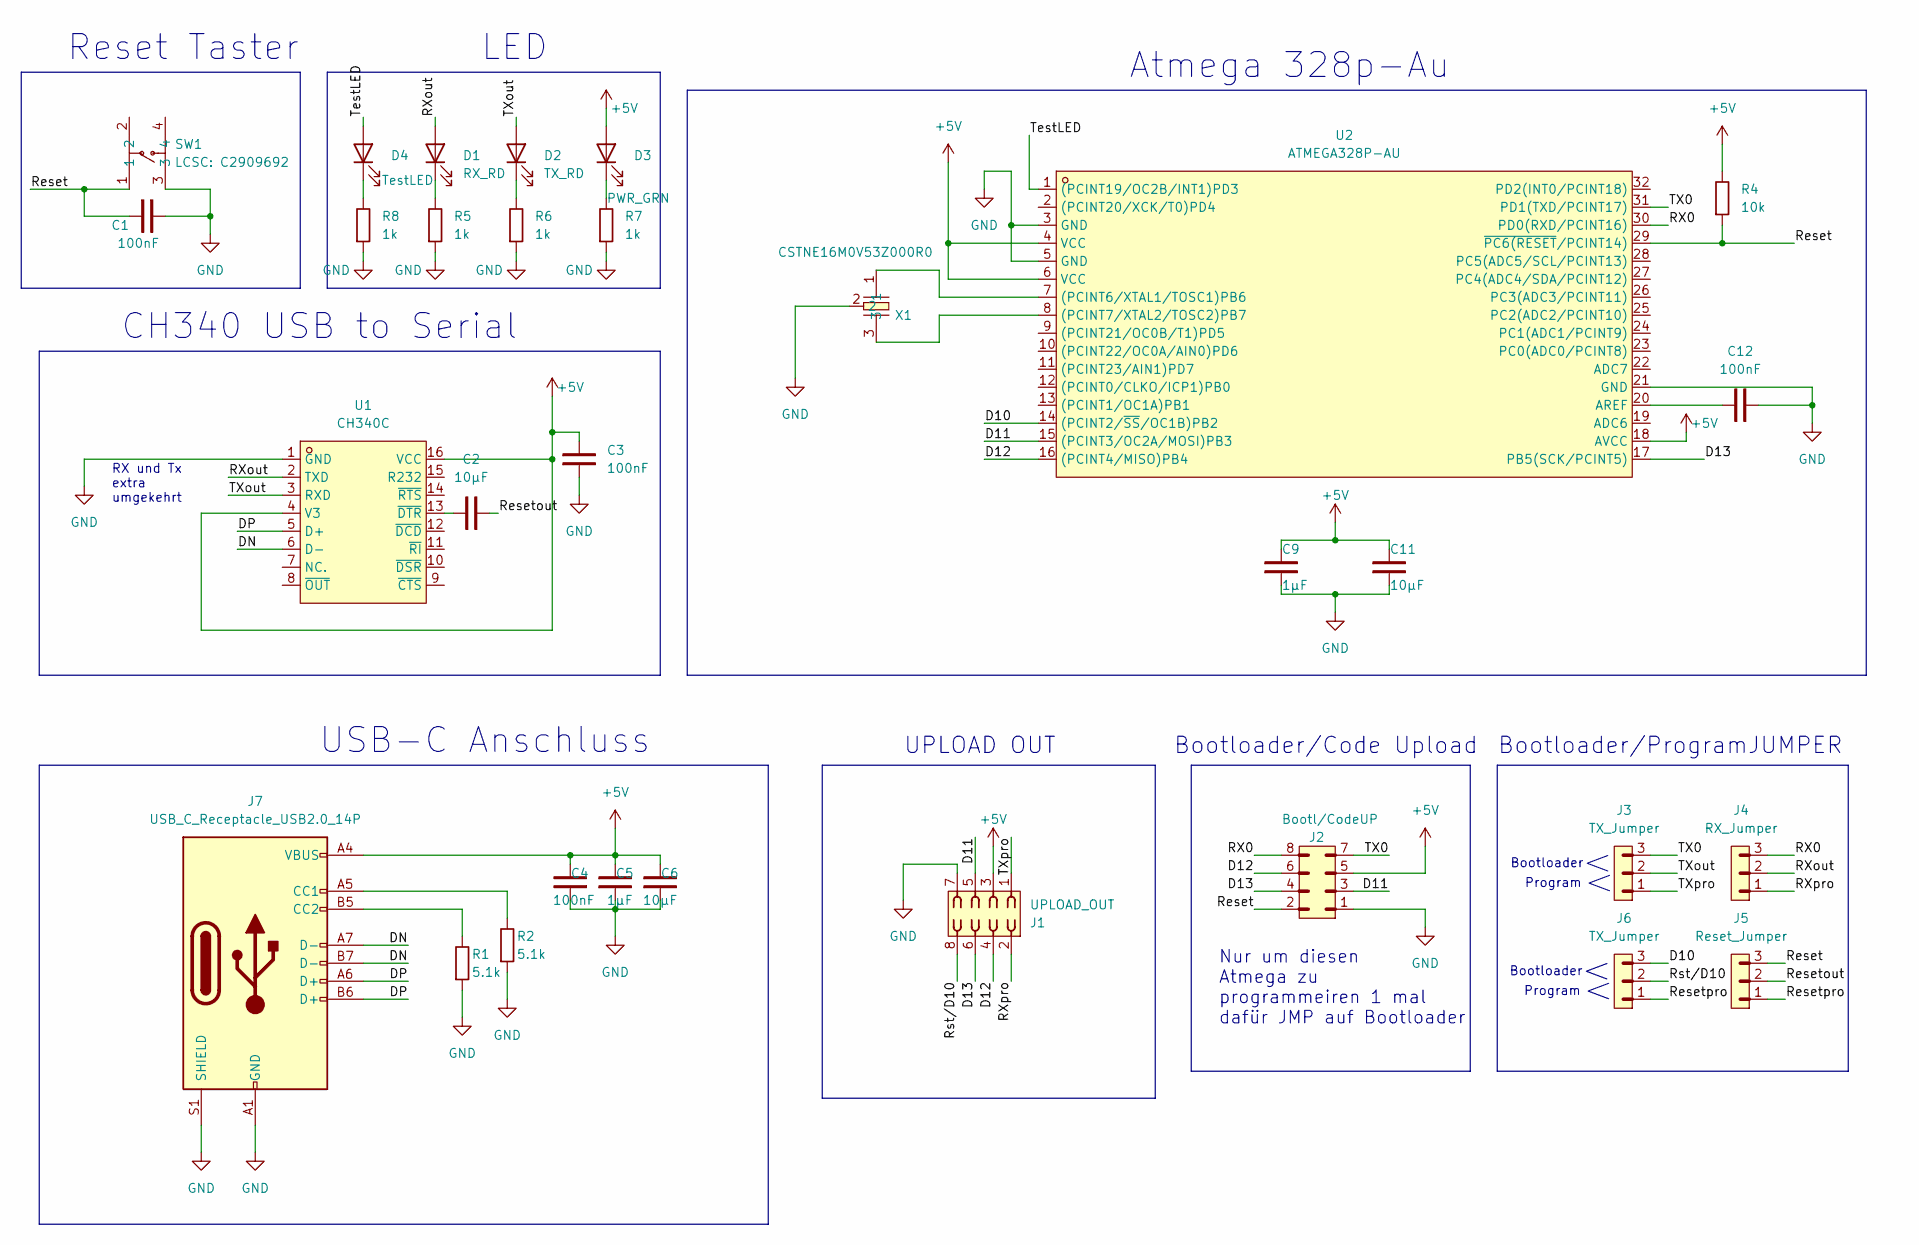
[picture p85: schematic Atmega_Programmer.kicad_sch]

Parts:
C1, C3, C4, C12: 100nF; C_0805_2012Metric
C2, C6, C11: 10µF; C_0805_2012Metric
C5, C9: 1µF; C_0805_2012Metric
D1: RX_RD; LED_0805_2012Metric
D2: TX_RD; LED_0805_2012Metric
D3: PWR_GRN; LED_0805_2012Metric
D4: TestLED; LED_0805_2012Metric
J1: UPLOAD_OUT; PinSocket_2x04_P2.54mm_Vertical
J2: Bootl/CodeUP; PinHeader_2x04_P2.54mm_Vertical
J3, J6: TX_Jumper; PinHeader_1x03_P2.54mm_Vertical
J4: RX_Jumper; PinHeader_1x03_P2.54mm_Vertical
J5: Reset_Jumper; PinHeader_1x03_P2.54mm_Vertical
J7: USB_C_Receptacle_USB2.0_14P; USB_C_Receptacle_HRO_TYPE-C-31-M-12
R1, R2: 5.1k; R_0805_2012Metric
R4: 10k; R_0805_2012Metric
R5, R6, R7, R8: 1k; R_0805_2012Metric
SW1: LCSC: C2909692; SW-SMD_4P-L6.2-W6.2-P4.50-LS8.6; LCSC Part C2909692
U1: CH340C; SOP-16_L10.0-W3.9-P1.27-LS6.0-BL; LCSC Part C84681
U2: ATMEGA328P-AU; TQFP-32_L7.0-W7.0-P0.80-LS9.0-BL; LCSC Part C14877
X1: CSTNE16M0V53Z000R0; OSC-SMD_3P-L3.2-W1.3-P1.20-L; LCSC Part C783275

Connections:
+5V: C3.2, C4.1, C5.2, C6.2, C9.2, C11.2, D3.2 (A), J1.3, J2.5, J7.A4 (VBUS), J7.A9 (VBUS), J7.B4 (VBUS), J7.B9 (VBUS), R4.2, U1.4 (V3), U1.16 (VCC), U2.4 (VCC), U2.6 (VCC), U2.18 (AVCC)
/D10: J6.3, U2.14 ((PCINT2/~SS/OC1B)PB2)
/D11: J1.5, J2.3, U2.15 ((PCINT3/OC2A/MOSI)PB3)
/D12: J1.4, J2.6, U2.16 ((PCINT4/MISO)PB4)
/D13: J1.6, J2.4, U2.17 (PB5(SCK/PCINT5))
/DN: J7.A7 (D-), J7.B7 (D-), U1.6 (D-)
/DP: J7.A6 (D+), J7.B6 (D+), U1.5 (D+)
/RX0: J2.8, J4.3, U2.30 (PD0(RXD/PCINT16))
/RXout: D1.2 (A), J4.2, U1.2 (TXD)
/RXpro: J1.2, J4.1
/Reset: C1.1, J2.2, J5.3, R4.1, SW1.1, U2.29 (~PC6(RESET/PCINT14))
/Resetout: C2.1, J5.2
/Resetpro: J5.1, J6.1
/Rst/D10: J1.8, J6.2
/TX0: J2.7, J3.3, U2.31 (PD1(TXD/PCINT17))
/TXout: D2.2 (A), J3.2, U1.3 (RXD)
/TXpro: J1.1, J3.1
/TestLED: D4.2 (A), U2.1 ((PCINT19/OC2B/INT1)PD3)
GND: C1.2, C3.1, C4.2, C5.1, C6.1, C9.1, C11.1, C12.1, J1.7, J2.1, J7.A1 (GND), J7.A12 (GND), J7.B1 (GND), J7.B12 (GND), J7.S1 (SHIELD), R1.1, R2.1, R5.1, R6.1, R7.1, R8.1, SW1.3, U1.1 (GND), U2.3 (GND), U2.5 (GND), U2.21 (GND), X1.2
unnamed: D1.1 (K), R5.2
unnamed: D2.1 (K), R6.2
unnamed: D3.1 (K), R7.2
unnamed: D4.1 (K), R8.2
unnamed: J7.A5 (CC1), R2.2
unnamed: J7.B5 (CC2), R1.2
unnamed: C2.2, U1.13 (~DTR)
unnamed: U2.7 ((PCINT6/XTAL1/TOSC1)PB6), X1.1
unnamed: U2.8 ((PCINT7/XTAL2/TOSC2)PB7), X1.3
unnamed: C12.2, U2.20 (AREF)

Notes on the sheet:
Reset Taster
CH340 USB to Serial
Atmega 328p-Au
RX und Tx extra umgekehrt
USB-C Anschluss
Nur um diesen Atmega zu programmeiren 1 mal dafür JMP auf Bootloader
UPLOAD OUT
Bootloader
Bootloader/ProgramJUMPER
Bootloader/Code Upload
LED
Program

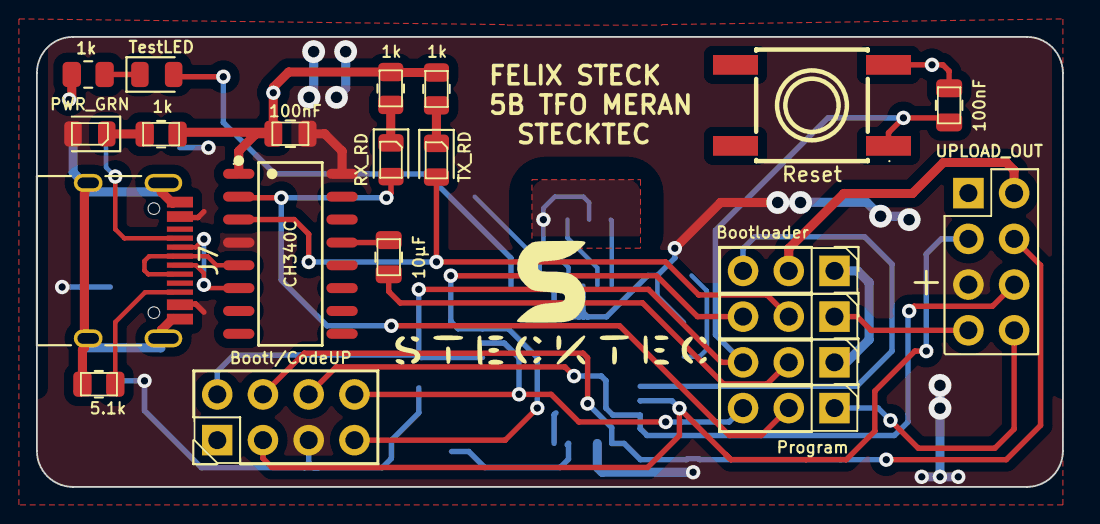
[picture p86: board Atmega_Programmer.kicad_pcb from above]

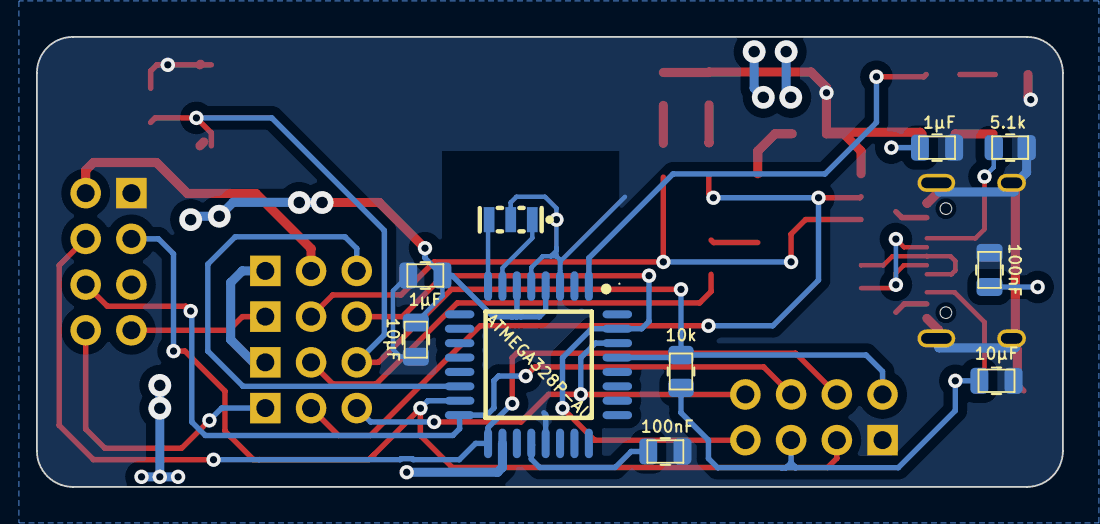
[picture p87: board Atmega_Programmer.kicad_pcb from below]

Board: 2 copper layers, 57.0 x 25.0 mm, 31 parts (10 on the bottom side), 29 nets.
