06Felix06/Stecktec-EIC_GitHub/hardware/01_Hauptplatine_V2/HauptplatineEIC_V2.kicad_pcb

## KiCad design hardware/01_Hauptplatine_V2/HauptplatineEIC_V2.kicad_pcb (2026-11-07)

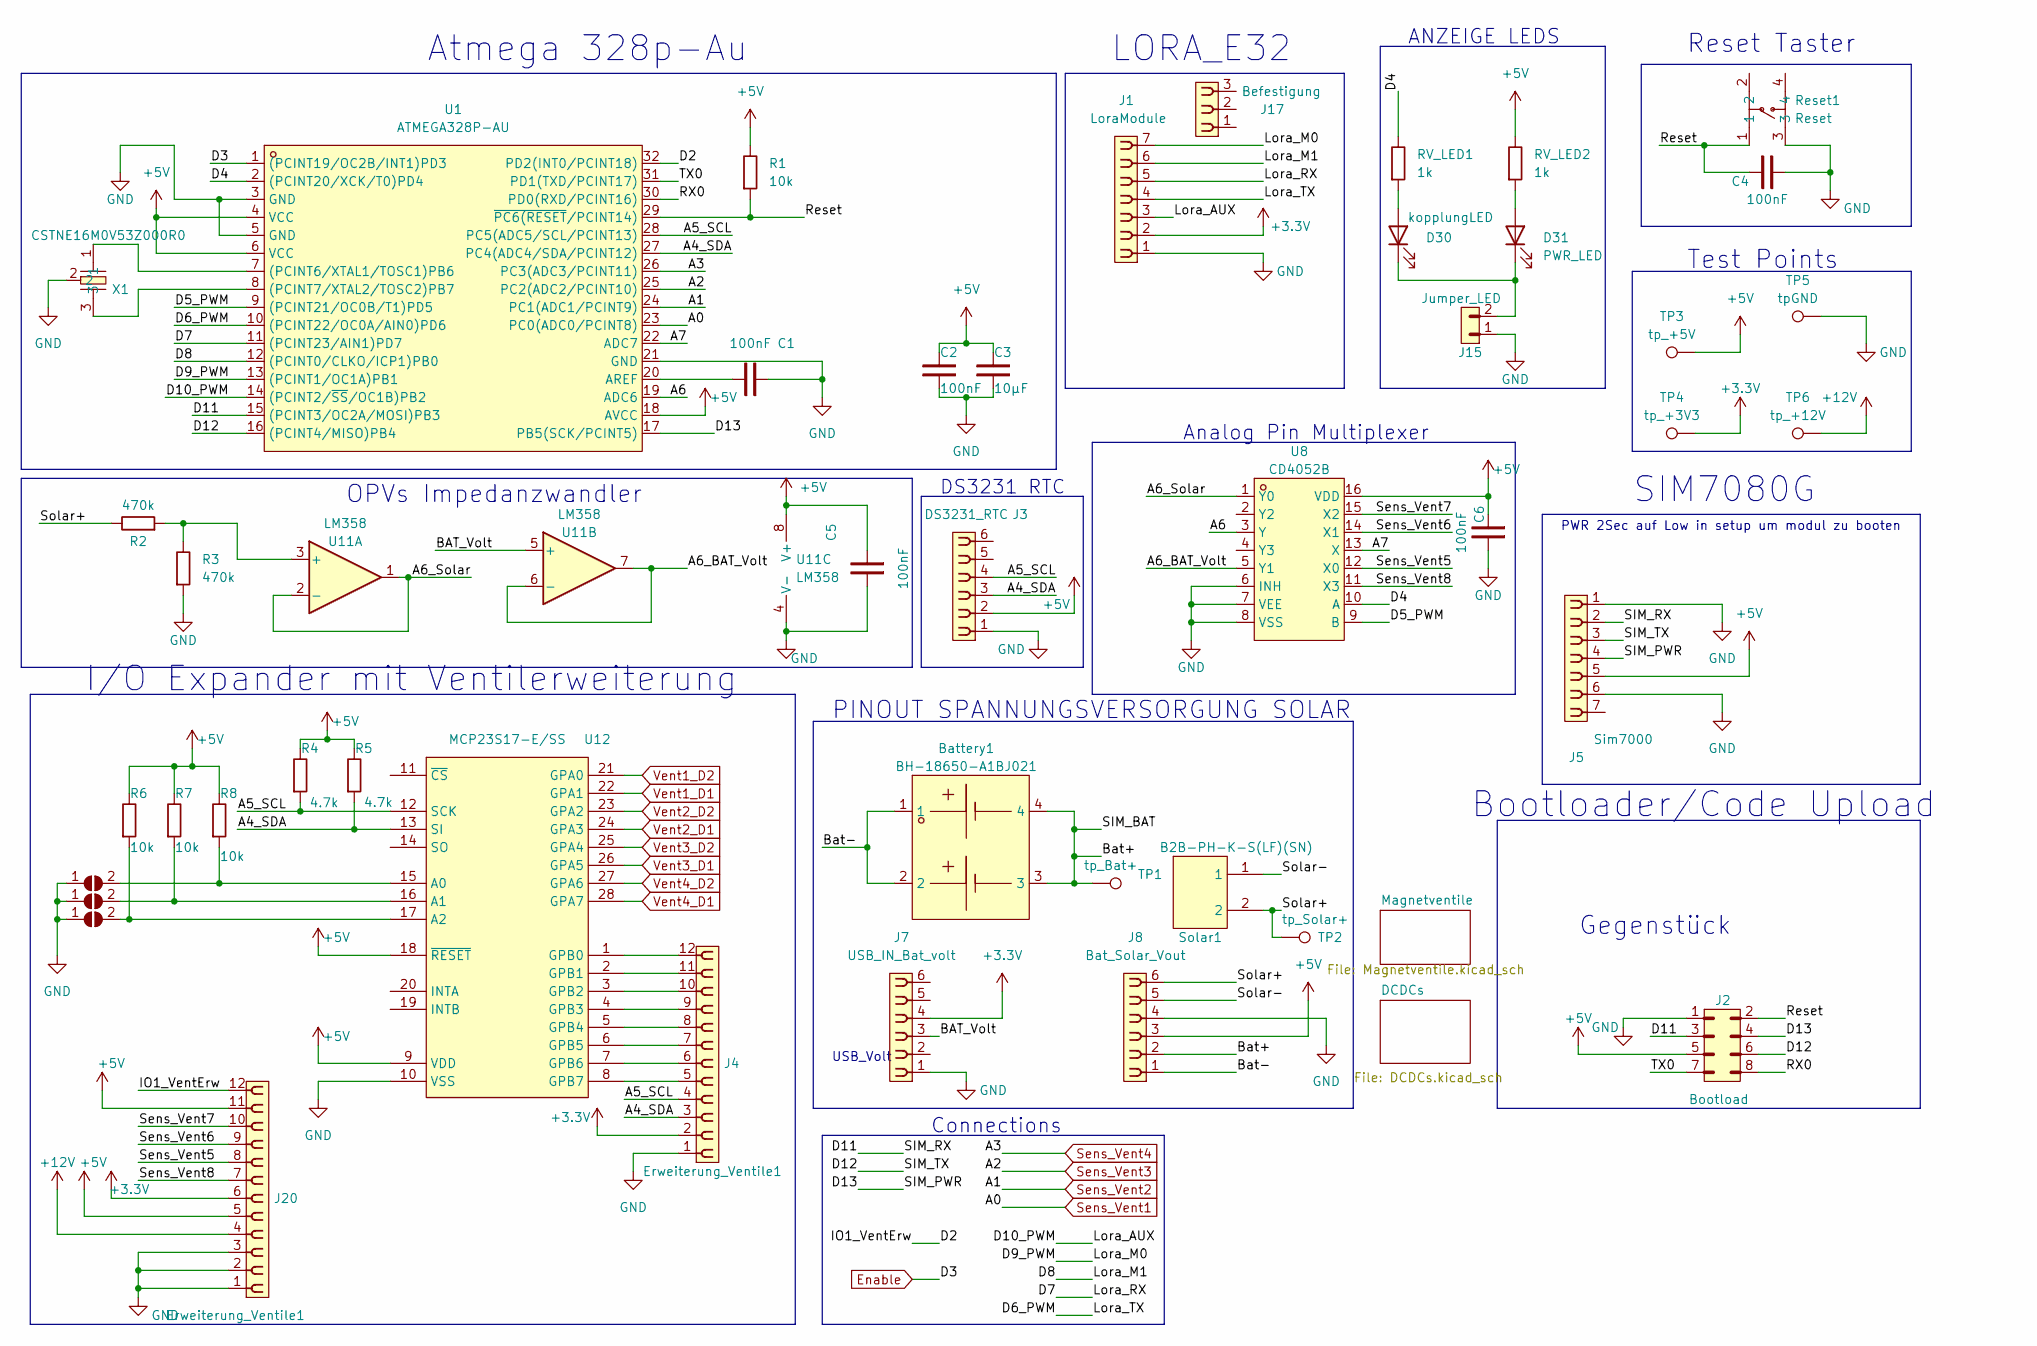
[picture p88: schematic HauptplatineEIC_V2.kicad_sch]

Parts:
Battery1: BH-18650-A1BJ021; BAT-TH_L77.0-W39.9_BH-18650-A1BJ021; LCSC Part C20606804
C1, C2, C4, C5, C6: 100nF; C_0805_2012Metric
C3: 10µF; C_0805_2012Metric
D30: kopplungLED; LED_0805_2012Metric
D31: PWR_LED; LED_0805_2012Metric
J1: LoraModule; PinSocket_1x07_P2.54mm_Vertical
J2: Bootload; PinHeader_2x04_P2.54mm_Vertical
J3: DS3231_RTC; PinSocket_1x06_P2.54mm_Vertical
J4, J20: Erweiterung_Ventile1; PinSocket_1x12_P2.54mm_Vertical
J5: Sim7000; PinSocket_1x07_P2.54mm_Vertical
J7: USB_IN_Bat_volt; PinSocket_1x06_P2.54mm_Vertical
J8: Bat_Solar_Vout; PinSocket_1x06_P2.54mm_Vertical
J15: Jumper_LED; PinHeader_1x02_P2.54mm_Vertical
J17: Befestigung; PinSocket_1x03_P2.54mm_Vertical
JP4, JP5, JP6: SolderJumper_2_Open; SolderJumper-2_P1.3mm_Open_Pad1.0x1.5mm
R1, R6, R7, R8: 10k; R_0805_2012Metric
R2, R3: 470k; R_0805_2012Metric
R4, R5: 4.7k; R_0805_2012Metric
RV_LED1, RV_LED2: 1k; R_0805_2012Metric
Reset1: Reset; SW-SMD_4P-L6.2-W6.2-P4.50-LS8.6; LCSC Part C2909692
Solar1: B2B-PH-K-S(LF)(SN); CONN-TH_B2B-PH-K-S; LCSC Part C131337
TP1: tp_Bat+; TPSteckFelix
TP2: tp_Solar+; TPSteckFelix
TP3: tp_+5V; TPSteckFelix
TP4: tp_+3V3; TPSteckFelix
TP5: tpGND; TPSteckFelix
TP6: tp_+12V; TPSteckFelix
U1: ATMEGA328P-AU; TQFP-32_L7.0-W7.0-P0.80-LS9.0-BL; LCSC Part C14877
U8: CD4052B; SOIC-16_L9.9-W3.9-P1.27-LS6.0-BL; LCSC Part C5356105
U11: LM358; SOIC-8_L5.0-W4.0-P1.27-LS6.0-BL
U12: MCP23S17-E/SS; SSOP-28_L10.2-W5.3-P0.65-LS7.8-BL; LCSC Part C148009
X1: CSTNE16M0V53Z000R0; OSC-SMD_3P-L3.2-W1.3-P1.20-L; LCSC Part C783275

Connections:
+3.3V: J1.2, J4.2, J7.4, J20.6, TP4.1
+5V: C2.2, C3.2, C5.1, C6.1, J2.5, J3.2, J5.5, J8.3, J20.5, J20.11, R1.2, R4.2, R5.2, R6.2, R7.2, R8.2, RV_LED2.2, TP3.1, U1.4 (VCC), U1.6 (VCC), U1.18 (AVCC), U8.16 (VDD), U11.8 (V+), U12.9 (VDD), U12.18 (~RESET); also elsewhere on the board
+12V: J20.4, TP6.1; also elsewhere on the board
/A4_SDA: J3.3, J4.3, R5.1, U1.27 (PC4(ADC4/SDA/PCINT12)), U12.13 (SI)
/A5_SCL: J3.4, J4.4, R4.1, U1.28 (PC5(ADC5/SCL/PCINT13)), U12.12 (SCK)
/A6: U1.19 (ADC6), U8.3 (Y)
/A6_BAT_Volt: U8.5 (Y1), U11.6 (-), U11.7
/A6_Solar: U8.1 (Y0), U11.1, U11.2 (-)
/A7: U1.22 (ADC7), U8.13 (X)
/BAT_Volt: J7.3, U11.5 (+)
/Bat+: Battery1.3, Battery1.4, J8.2, TP1.1
/Bat-: Battery1.1, Battery1.2, J8.1
/D2: J20.12, U1.32 (PD2(INT0/PCINT18))
/D4: RV_LED1.2, U1.2 ((PCINT20/XCK/T0)PD4), U8.10 (A)
/D5_PWM: U1.9 ((PCINT21/OC0B/T1)PD5), U8.9 (B)
/D6_PWM: J1.4, U1.10 ((PCINT22/OC0A/AIN0)PD6)
/D7: J1.5, U1.11 ((PCINT23/AIN1)PD7)
/D8: J1.6, U1.12 ((PCINT0/CLKO/ICP1)PB0)
/D9_PWM: J1.7, U1.13 ((PCINT1/OC1A)PB1)
/D10_PWM: J1.3, U1.14 ((PCINT2/~SS/OC1B)PB2)
/D11: J2.3, J5.2, U1.15 ((PCINT3/OC2A/MOSI)PB3)
/D12: J2.6, J5.3, U1.16 ((PCINT4/MISO)PB4)
/D13: J2.4, J5.4, U1.17 (PB5(SCK/PCINT5))
/RX0: J2.8, U1.30 (PD0(RXD/PCINT16))
/Reset: C4.1, J2.2, R1.1, Reset1.1, U1.29 (~PC6(RESET/PCINT14))
/Sens_Vent5: J20.8, U8.12 (X0)
/Sens_Vent6: J20.9, U8.14 (X1)
/Sens_Vent7: J20.10, U8.15 (X2)
/Sens_Vent8: J20.7, U8.11 (X3)
/Solar+: J8.6, R2.2, Solar1.2, TP2.1
/Solar-: J8.5, Solar1.1
/TX0: J2.7, U1.31 (PD1(TXD/PCINT17))
Enable: U1.1 ((PCINT19/OC2B/INT1)PD3); also elsewhere on the board
GND: C1.1, C2.1, C3.1, C4.2, C5.2, C6.2, J1.1, J2.1, J3.1, J4.1, J5.1, J5.6, J7.1, J8.4, J15.1, J20.1, J20.2, J20.3, JP4.1 (A), JP5.1 (A), JP6.1 (A), R3.1, Reset1.3, TP5.1, U1.3 (GND), U1.5 (GND), U1.21 (GND), U8.6 (INH), U8.7 (VEE), U8.8 (VSS), U11.4 (V-), U12.10 (VSS), X1.2; also elsewhere on the board
unnamed: D30.2 (A), RV_LED1.1
unnamed: D30.1 (K), D31.1 (K), J15.2
unnamed: D31.2 (A), RV_LED2.1
unnamed: JP4.2 (B), R8.1, U12.15 (A0)
unnamed: JP5.2 (B), R7.1, U12.16 (A1)
unnamed: JP6.2 (B), R6.1, U12.17 (A2)
unnamed: U1.7 ((PCINT6/XTAL1/TOSC1)PB6), X1.1
unnamed: U1.8 ((PCINT7/XTAL2/TOSC2)PB7), X1.3
unnamed: C1.2, U1.20 (AREF)
unnamed: R2.1, R3.2, U11.3 (+)
unnamed: J4.12, U12.1 (GPB0)
unnamed: J4.11, U12.2 (GPB1)
unnamed: J4.10, U12.3 (GPB2)
unnamed: J4.9, U12.4 (GPB3)
unnamed: J4.8, U12.5 (GPB4)
unnamed: J4.7, U12.6 (GPB5)
unnamed: J4.6, U12.7 (GPB6)
unnamed: J4.5, U12.8 (GPB7)
Sens_Vent1: U1.23 (PC0(ADC0/PCINT8)); also elsewhere on the board
Sens_Vent2: U1.24 (PC1(ADC1/PCINT9)); also elsewhere on the board
Sens_Vent3: U1.25 (PC2(ADC2/PCINT10)); also elsewhere on the board
Sens_Vent4: U1.26 (PC3(ADC3/PCINT11)); also elsewhere on the board
Vent1_D1: U12.22 (GPA1); also elsewhere on the board
Vent1_D2: U12.21 (GPA0); also elsewhere on the board
Vent2_D1: U12.24 (GPA3); also elsewhere on the board
Vent2_D2: U12.23 (GPA2); also elsewhere on the board
Vent3_D1: U12.26 (GPA5); also elsewhere on the board
Vent3_D2: U12.25 (GPA4); also elsewhere on the board
Vent4_D1: U12.28 (GPA7); also elsewhere on the board
Vent4_D2: U12.27 (GPA6); also elsewhere on the board

Notes on the sheet:
Analog Pin Multiplexer
I/O Expander mit Ventilerweiterung
Bootloader/Code Upload
Atmega 328p-Au
Connections
LORA_E32
Gegenstück
Test Points
PWR 2Sec auf Low in setup um modul zu booten
USB_Volt
PINOUT SPANNUNGSVERSORGUNG SOLAR
DS3231 RTC
ANZEIGE LEDS
SIM7080G
OPVs Impedanzwandler
Reset Taster

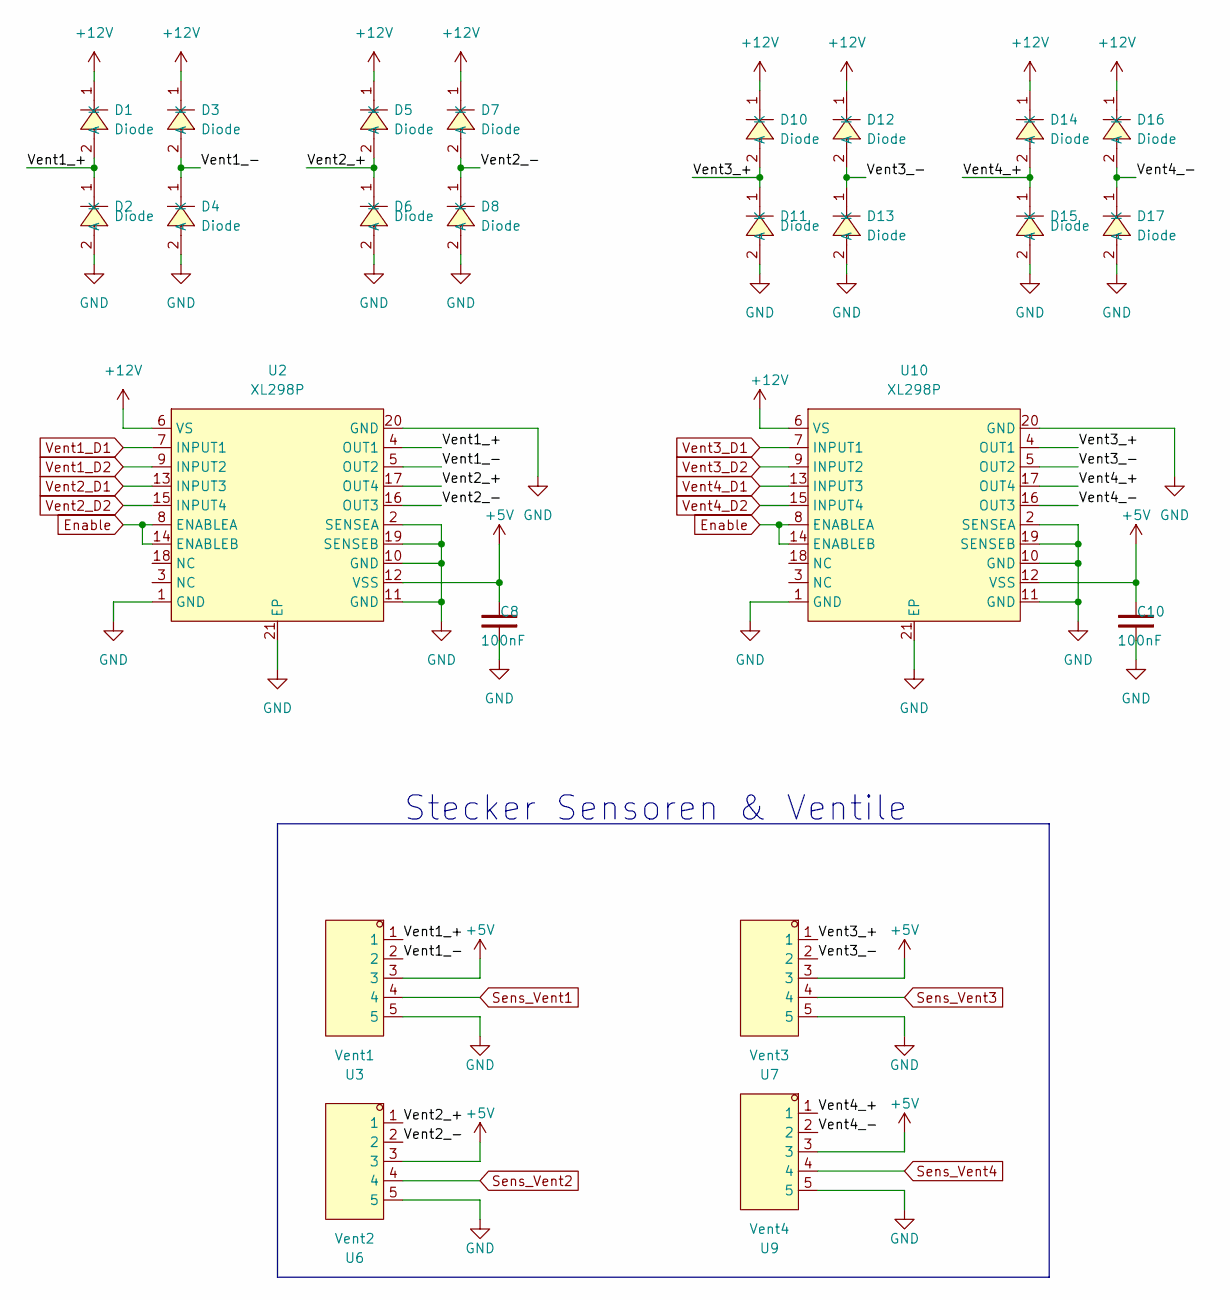
[picture p89: schematic Magnetventile.kicad_sch]

Parts:
C8, C10: 100nF; C_0805_2012Metric
D1, D2, D3, D4, D5, D6, D7, D8, D10, D11, D12, D13, D14, D15, D16, D17: Diode; SMA_L4.3-W2.5-LS5.0-RD; LCSC Part C727081
U2, U10: XL298P; HSOP-20_L15.9-W11.0-P1.27-LS14.2-BL-EP; LCSC Part C17179540
U3: Vent1; CONN-TH_B5B-PH-K-S-LF-SN; LCSC Part C157993
U6: Vent2; CONN-TH_B5B-PH-K-S-LF-SN; LCSC Part C157993
U7: Vent3; CONN-TH_B5B-PH-K-S-LF-SN; LCSC Part C157993
U9: Vent4; CONN-TH_B5B-PH-K-S-LF-SN; LCSC Part C157993

Connections:
+5V: C8.1, C10.1, U2.12 (VSS), U3.3, U6.3, U7.3, U9.3, U10.12 (VSS); also elsewhere on the board
+12V: D1.1 (K), D3.1 (K), D5.1 (K), D7.1 (K), D10.1 (K), D12.1 (K), D14.1 (K), D16.1 (K), U2.6 (VS), U10.6 (VS); also elsewhere on the board
/Magnetventile/Vent1_+: D1.2 (A), D2.1 (K), U2.4 (OUT1), U3.1
/Magnetventile/Vent1_-: D3.2 (A), D4.1 (K), U2.5 (OUT2), U3.2
/Magnetventile/Vent2_+: D5.2 (A), D6.1 (K), U2.17 (OUT4), U6.1
/Magnetventile/Vent2_-: D7.2 (A), D8.1 (K), U2.16 (OUT3), U6.2
/Magnetventile/Vent3_+: D10.2 (A), D11.1 (K), U7.1, U10.4 (OUT1)
/Magnetventile/Vent3_-: D12.2 (A), D13.1 (K), U7.2, U10.5 (OUT2)
/Magnetventile/Vent4_+: D14.2 (A), D15.1 (K), U9.1, U10.17 (OUT4)
/Magnetventile/Vent4_-: D16.2 (A), D17.1 (K), U9.2, U10.16 (OUT3)
Enable: U2.8 (ENABLEA), U2.14 (ENABLEB), U10.8 (ENABLEA), U10.14 (ENABLEB); also elsewhere on the board
GND: C8.2, C10.2, D2.2 (A), D4.2 (A), D6.2 (A), D8.2 (A), D11.2 (A), D13.2 (A), D15.2 (A), D17.2 (A), U2.1 (GND), U2.2 (SENSEA), U2.10 (GND), U2.11 (GND), U2.19 (SENSEB), U2.20 (GND), U2.21 (EP), U3.5, U6.5, U7.5, U9.5, U10.1 (GND), U10.2 (SENSEA), U10.10 (GND), U10.11 (GND), U10.19 (SENSEB), U10.20 (GND), U10.21 (EP); also elsewhere on the board
Sens_Vent1: U3.4; also elsewhere on the board
Sens_Vent2: U6.4; also elsewhere on the board
Sens_Vent3: U7.4; also elsewhere on the board
Sens_Vent4: U9.4; also elsewhere on the board
Vent1_D1: U2.7 (INPUT1); also elsewhere on the board
Vent1_D2: U2.9 (INPUT2); also elsewhere on the board
Vent2_D1: U2.13 (INPUT3); also elsewhere on the board
Vent2_D2: U2.15 (INPUT4); also elsewhere on the board
Vent3_D1: U10.7 (INPUT1); also elsewhere on the board
Vent3_D2: U10.9 (INPUT2); also elsewhere on the board
Vent4_D1: U10.13 (INPUT3); also elsewhere on the board
Vent4_D2: U10.15 (INPUT4); also elsewhere on the board

Notes on the sheet:
Stecker Sensoren & Ventile

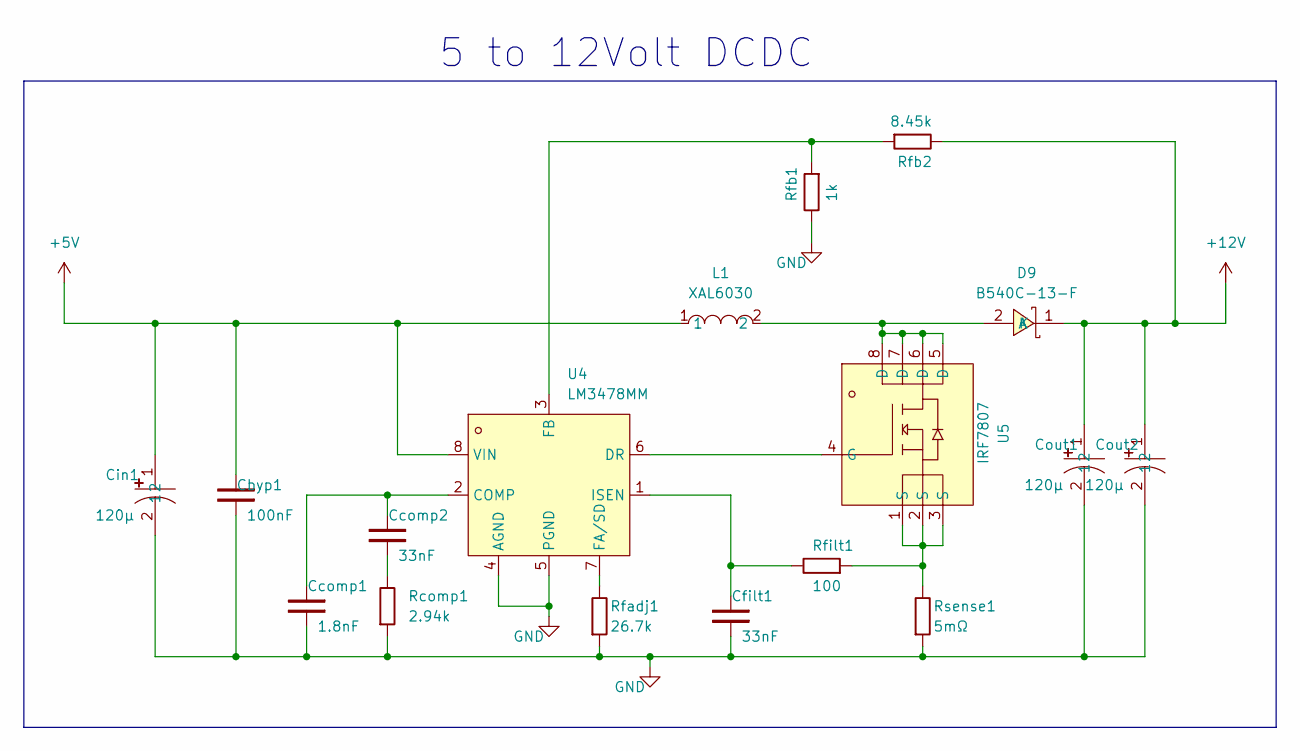
[picture p90: schematic DCDCs.kicad_sch]

Parts:
Cbyp1: 100nF; C_0805_2012Metric
Ccomp1: 1.8nF; C_0805_2012Metric
Ccomp2: 33nF; C_0805_2012Metric
Cfilt1: 33nF; C_0805_2012Metric
Cin1: 120µ; CAP-TH_BD6.3-P2.50-D1.0-FD; LCSC Part C442997
Cout1, Cout2: 120µ; CAP-TH_BD6.3-P2.50-D1.0-FD; LCSC Part C442997
D9: B540C-13-F; SMC_L7.1-W6.2-LS8.1-RD; LCSC Part C72264
L1: XAL6030; IND-SMD_L6.6-W6.4; LCSC Part C19191693
Rcomp1: 2.94k; R_0805_2012Metric
Rfadj1: 26.7k; R_0805_2012Metric
Rfb1: 1k; R_0805_2012Metric
Rfb2: 8.45k; R_0805_2012Metric
Rfilt1: 100; R_0805_2012Metric
Rsense1: 5mΩ; R_0805_2012Metric
U4: LM3478MM; VSSOP-8_L3.0-W3.0-P0.65-LS5.0-BL; LCSC Part C9404
U5: IRF7807; SOP-8_L4.9-W3.9-P1.27-LS6.0-BL; LCSC Part C5350865

Connections:
+5V: Cbyp1.1, Cin1.1, L1.1, U4.8 (VIN); also elsewhere on the board
+12V: Cout1.1, Cout2.1, D9.1 (K), Rfb2.2; also elsewhere on the board
GND: Cbyp1.2, Ccomp1.2, Cfilt1.2, Cin1.2, Cout1.2, Cout2.2, Rcomp1.1, Rfadj1.1, Rfb1.2, Rsense1.1, U4.4 (AGND), U4.5 (PGND); also elsewhere on the board
unnamed: Ccomp2.2, Rcomp1.2
unnamed: D9.2 (A), L1.2, U5.5 (D), U5.6 (D), U5.7 (D), U5.8 (D)
unnamed: Rfilt1.1, Rsense1.2, U5.1 (S), U5.2 (S), U5.3 (S)
unnamed: Ccomp1.1, Ccomp2.1, U4.2 (COMP)
unnamed: U4.6 (DR), U5.4 (G)
unnamed: Rfadj1.2, U4.7 (FA/SD)
unnamed: Rfb1.1, Rfb2.1, U4.3 (FB)
unnamed: Cfilt1.1, Rfilt1.2, U4.1 (ISEN)

Notes on the sheet:
5 to 12Volt DCDC

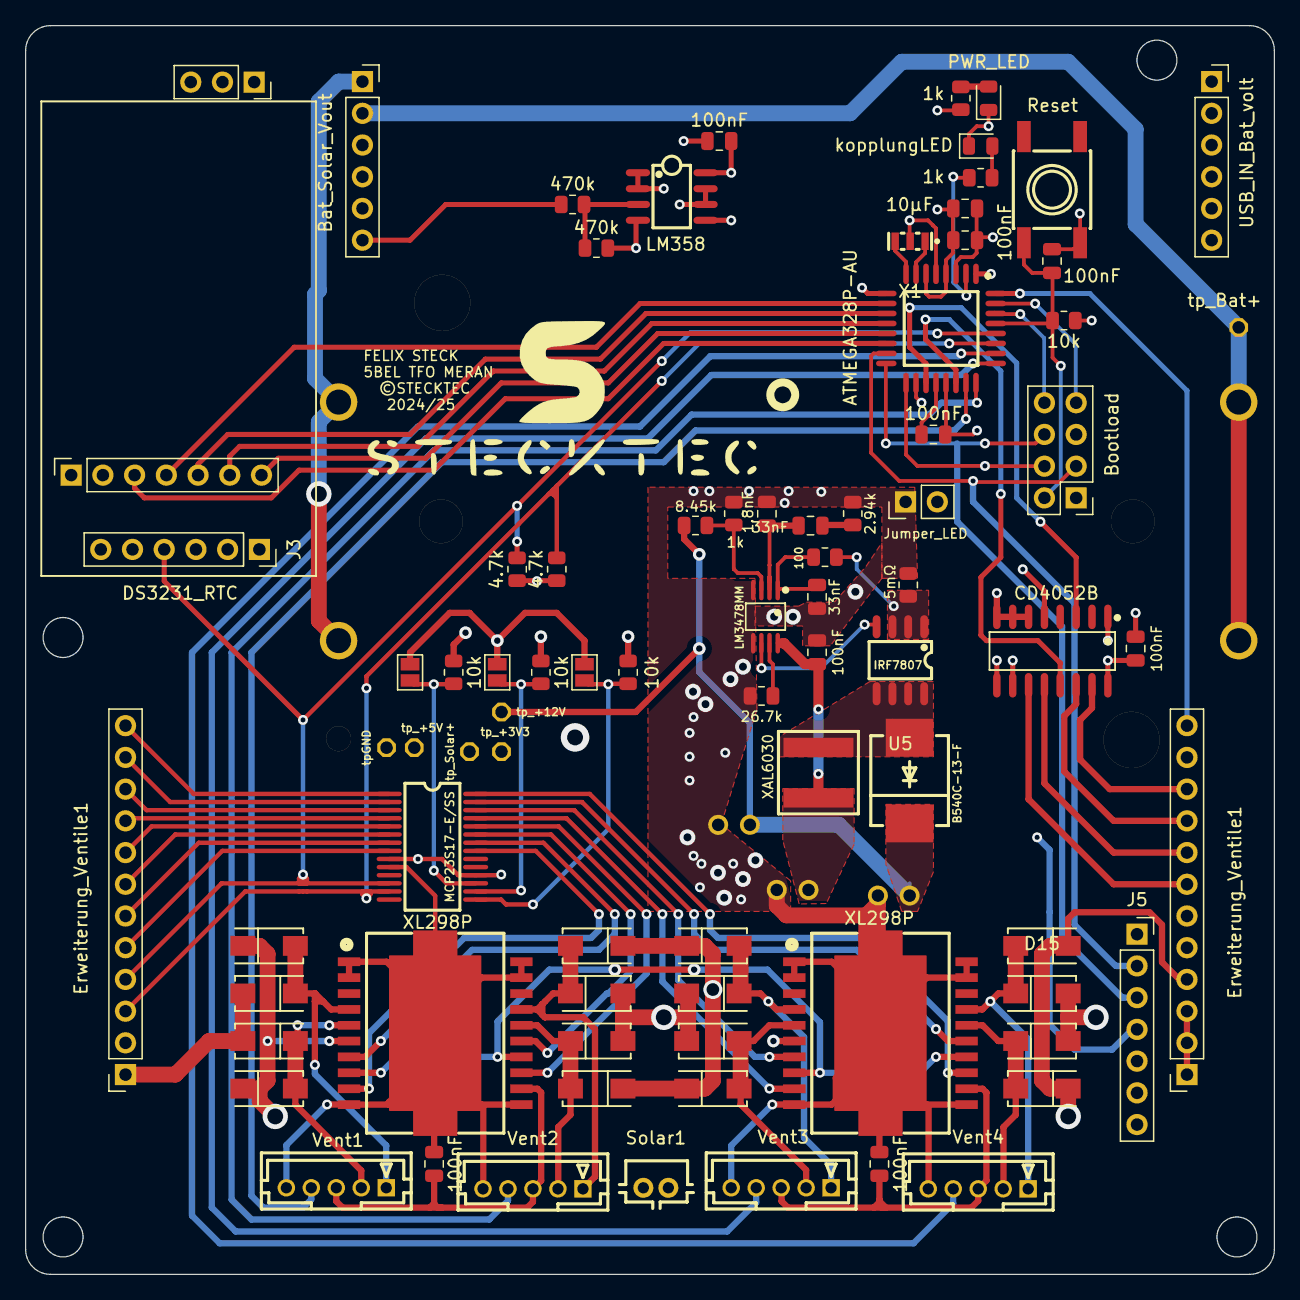
[picture p91: board HauptplatineEIC_V2.kicad_pcb from above]

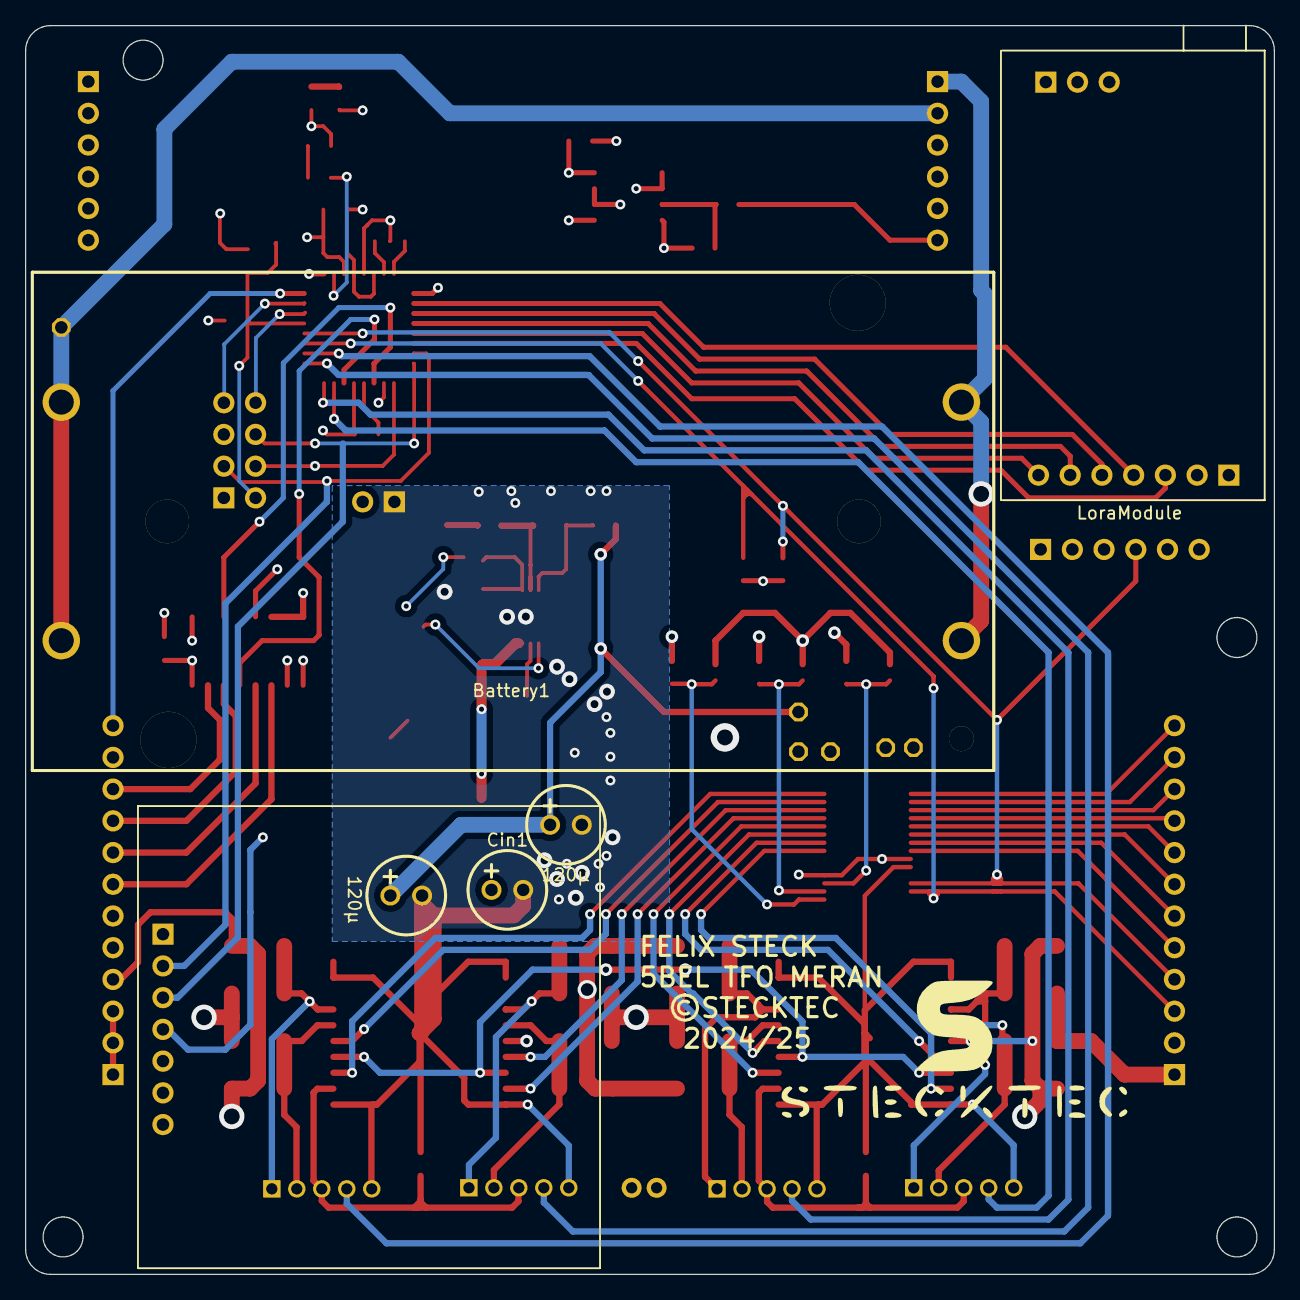
[picture p92: board HauptplatineEIC_V2.kicad_pcb from below]

Board: 6 copper layers, 100.0 x 100.0 mm, 86 parts (4 on the bottom side), 80 nets.
