06Felix06/Stecktec-EIC_GitHub/hardware/02_Sensorplatine/Sensor_Baseplatine_ohneUSB.kicad_pcb

## KiCad design hardware/02_Sensorplatine/Sensor_Baseplatine_ohneUSB.kicad_pcb (2026-11-07)

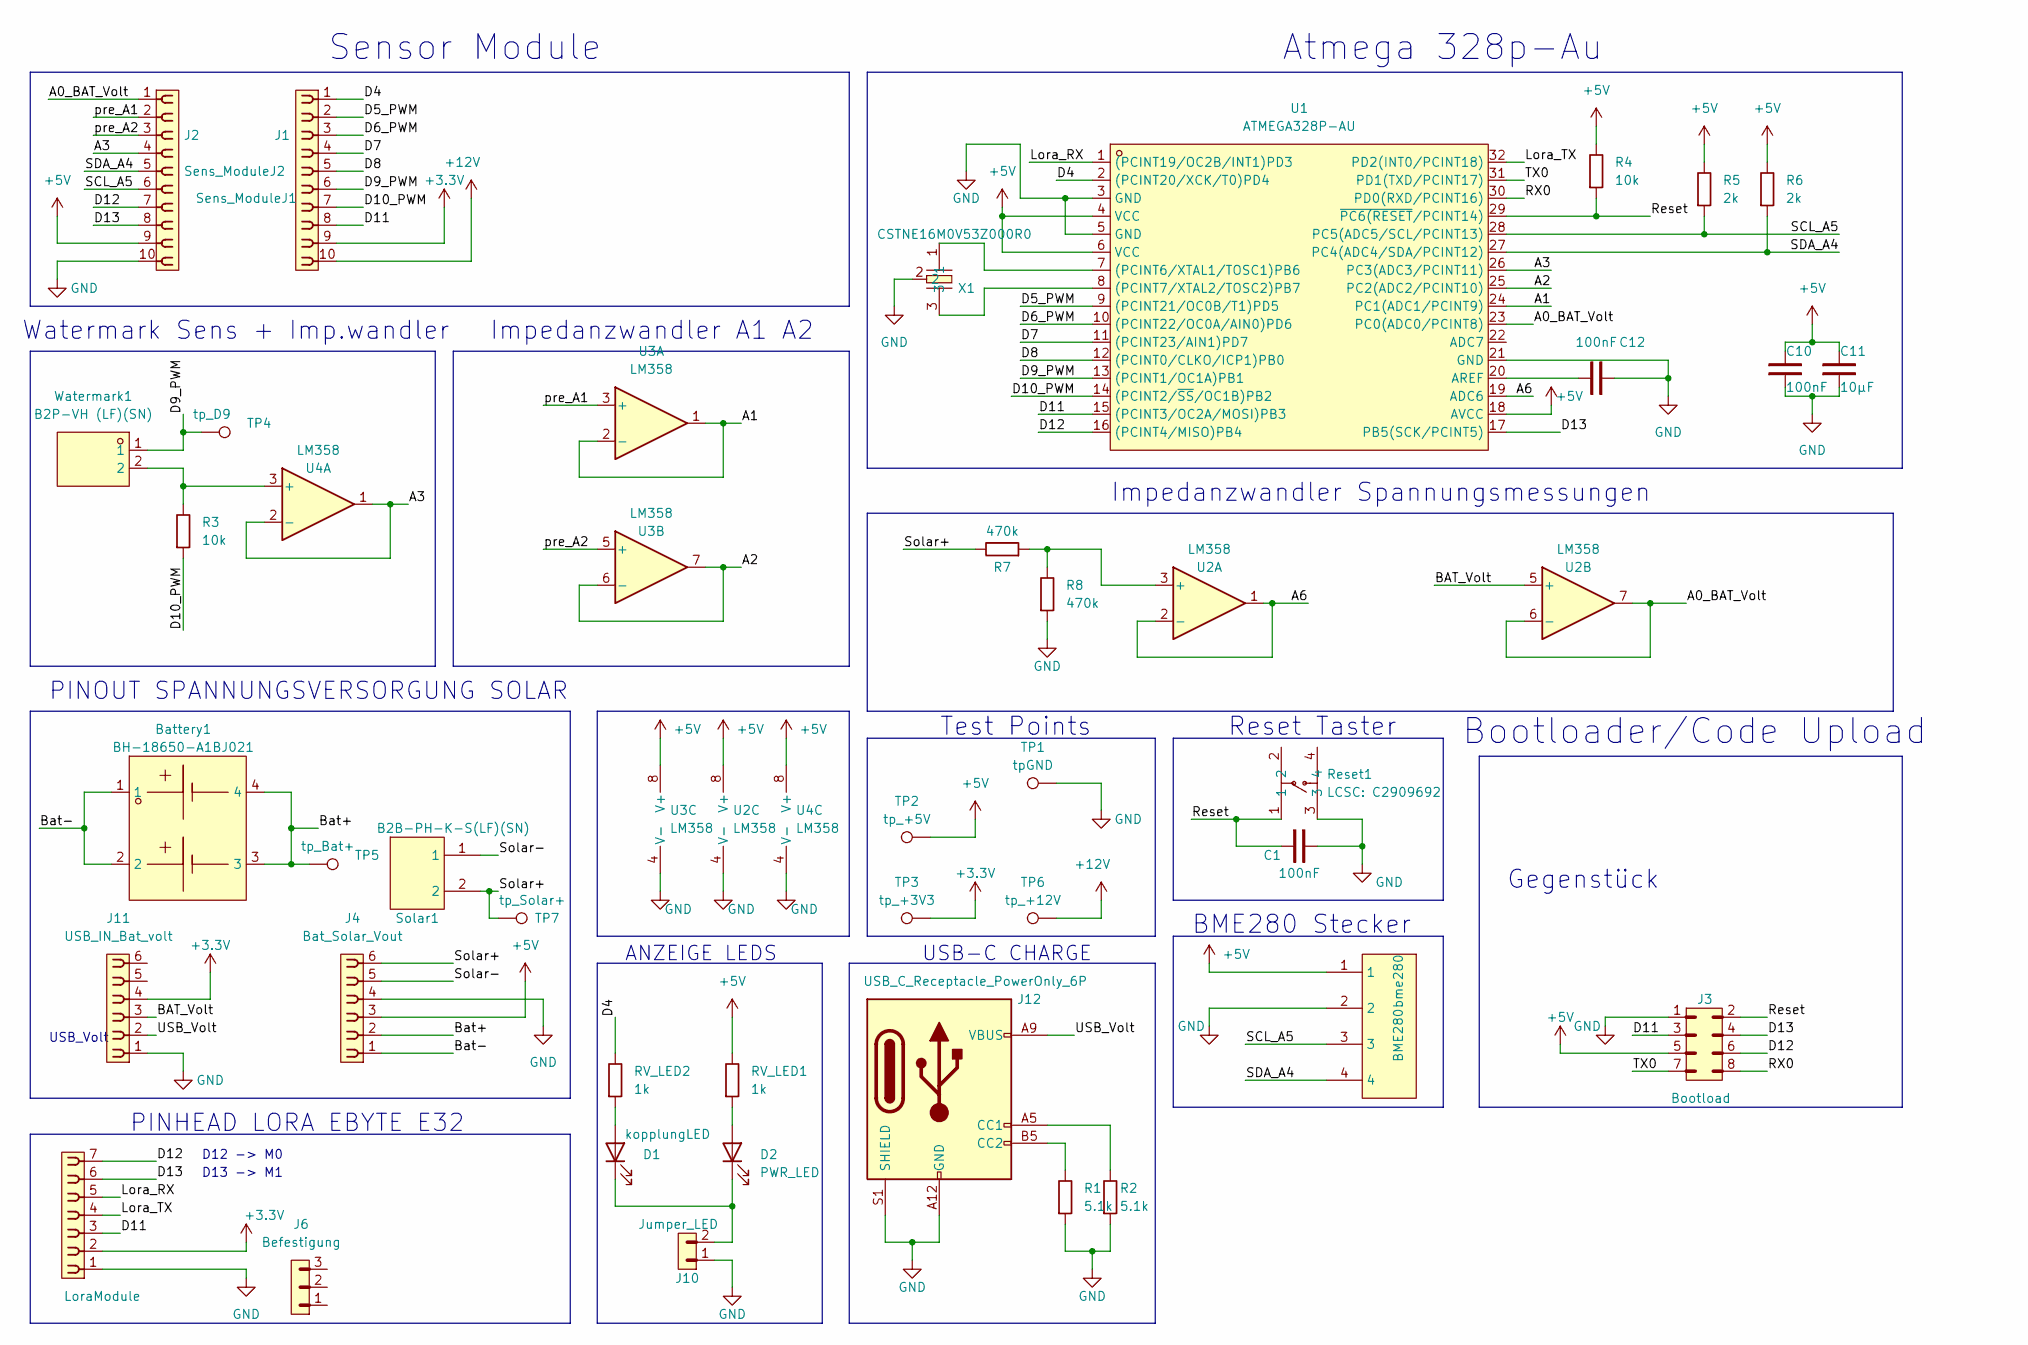
[picture p93: schematic Sensor_Baseplatine_ohneUSB.kicad_sch]

Parts:
Battery1: BH-18650-A1BJ021; BAT-TH_L77.0-W39.9_BH-18650-A1BJ021; LCSC Part C20606804
C1, C10, C12: 100nF; C_0805_2012Metric
C11: 10µF; C_0805_2012Metric
D1: kopplungLED; LED_0805_2012Metric
D2: PWR_LED; LED_0805_2012Metric
J1: Sens_ModuleJ1; PinSocket_1x10_P2.54mm_Vertical
J2: Sens_ModuleJ2; PinSocket_1x10_P2.54mm_Vertical
J3: Bootload; PinHeader_2x04_P2.54mm_Vertical
J4: Bat_Solar_Vout; PinSocket_1x06_P2.54mm_Vertical
J5: LoraModule; PinSocket_1x07_P2.54mm_Vertical
J6: Befestigung; PinHeader_1x03_P2.54mm_Vertical
J10: Jumper_LED; PinHeader_1x02_P2.54mm_Vertical
J11: USB_IN_Bat_volt; PinSocket_1x06_P2.54mm_Vertical
J12: USB_C_Receptacle_PowerOnly_6P; USB_C_Receptacle_GCT_USB4125-xx-x_6P_TopMnt_Horizontal
R1, R2: 5.1k; R_0805_2012Metric
R3, R4: 10k; R_0805_2012Metric
R5, R6: 2k; R_0805_2012Metric
R7, R8: 470k; R_0805_2012Metric
RV_LED1, RV_LED2: 1k; R_0805_2012Metric
Reset1: LCSC: C2909692; SW-SMD_4P-L6.2-W6.2-P4.50-LS8.6; LCSC Part C2909692
Solar1: B2B-PH-K-S(LF)(SN); CONN-TH_B2B-PH-K-S; LCSC Part C131337
TP1: tpGND; TPSteckFelix
TP2: tp_+5V; TPSteckFelix
TP3: tp_+3V3; TPSteckFelix
TP4: tp_D9; TPSteckFelix
TP5: tp_Bat+; TPSteckFelix
TP6: tp_+12V; TPSteckFelix
TP7: tp_Solar+; TPSteckFelix
U1: ATMEGA328P-AU; TQFP-32_L7.0-W7.0-P0.80-LS9.0-BL; LCSC Part C14877
U2, U3, U4: LM358; SOIC-8_L5.0-W4.0-P1.27-LS6.0-BL
Watermark1: B2P-VH (LF)(SN); CONN-TH_B2P-VH-LF-SN; LCSC Part C160315
X1: CSTNE16M0V53Z000R0; OSC-SMD_3P-L3.2-W1.3-P1.20-L; LCSC Part C783275
bme280: BME280; CONN-TH_B4B-PH-K-S; LCSC Part C131334

Connections:
+3.3V: J1.9, J5.2, J11.4, TP3.1
+5V: C10.2, C11.2, J2.9, J3.5, J4.3, R4.2, R5.2, R6.2, RV_LED1.2, TP2.1, U1.4 (VCC), U1.6 (VCC), U1.18 (AVCC), U2.8 (V+), U3.8 (V+), U4.8 (V+), bme280.1
+12V: J1.10, TP6.1
/A0_BAT_Volt: J2.1, U1.23 (PC0(ADC0/PCINT8)), U2.6 (-), U2.7
/A1: U1.24 (PC1(ADC1/PCINT9)), U3.1, U3.2 (-)
/A2: U1.25 (PC2(ADC2/PCINT10)), U3.6 (-), U3.7
/A3: J2.4, U1.26 (PC3(ADC3/PCINT11)), U4.1, U4.2 (-)
/A6: U1.19 (ADC6), U2.1, U2.2 (-)
/BAT_Volt: J11.3, U2.5 (+)
/Bat+: Battery1.3, Battery1.4, J4.2, TP5.1
/Bat-: Battery1.1, Battery1.2, J4.1
/D4: J1.1, RV_LED2.2, U1.2 ((PCINT20/XCK/T0)PD4)
/D5_PWM: J1.2, U1.9 ((PCINT21/OC0B/T1)PD5)
/D6_PWM: J1.3, U1.10 ((PCINT22/OC0A/AIN0)PD6)
/D7: J1.4, U1.11 ((PCINT23/AIN1)PD7)
/D8: J1.5, U1.12 ((PCINT0/CLKO/ICP1)PB0)
/D9_PWM: J1.6, TP4.1, U1.13 ((PCINT1/OC1A)PB1), Watermark1.1
/D10_PWM: J1.7, R3.1, U1.14 ((PCINT2/~SS/OC1B)PB2)
/D11: J1.8, J3.3, J5.3, U1.15 ((PCINT3/OC2A/MOSI)PB3)
/D12: J2.7, J3.6, J5.7, U1.16 ((PCINT4/MISO)PB4)
/D13: J2.8, J3.4, J5.6, U1.17 (PB5(SCK/PCINT5))
/Lora_RX: J5.5, U1.1 ((PCINT19/OC2B/INT1)PD3)
/Lora_TX: J5.4, U1.32 (PD2(INT0/PCINT18))
/RX0: J3.8, U1.30 (PD0(RXD/PCINT16))
/Reset: C1.1, J3.2, R4.1, Reset1.1, U1.29 (~PC6(RESET/PCINT14))
/SCL_A5: J2.6, R5.1, U1.28 (PC5(ADC5/SCL/PCINT13)), bme280.3
/SDA_A4: J2.5, R6.1, U1.27 (PC4(ADC4/SDA/PCINT12)), bme280.4
/Solar+: J4.6, R7.2, Solar1.2, TP7.1
/Solar-: J4.5, Solar1.1
/TX0: J3.7, U1.31 (PD1(TXD/PCINT17))
/USB_Volt: J11.2, J12.A9 (VBUS), J12.B9 (VBUS)
/pre_A1: J2.2, U3.3 (+)
/pre_A2: J2.3, U3.5 (+)
GND: C1.2, C10.1, C11.1, C12.1, J2.10, J3.1, J4.4, J5.1, J10.1, J11.1, J12.A12 (GND), J12.B12 (GND), J12.S1 (SHIELD), R1.1, R2.1, R8.1, Reset1.3, TP1.1, U1.3 (GND), U1.5 (GND), U1.21 (GND), U2.4 (V-), U3.4 (V-), U4.4 (V-), X1.2, bme280.2
unnamed: D1.2 (A), RV_LED2.1
unnamed: D1.1 (K), D2.1 (K), J10.2
unnamed: D2.2 (A), RV_LED1.1
unnamed: J12.A5 (CC1), R2.2
unnamed: J12.B5 (CC2), R1.2
unnamed: U1.7 ((PCINT6/XTAL1/TOSC1)PB6), X1.1
unnamed: U1.8 ((PCINT7/XTAL2/TOSC2)PB7), X1.3
unnamed: C12.2, U1.20 (AREF)
unnamed: R7.1, R8.2, U2.3 (+)
unnamed: R3.2, U4.3 (+), Watermark1.2

Notes on the sheet:
Gegenstück
Atmega 328p-Au
PINHEAD LORA EBYTE E32
USB-C CHARGE
Impedanzwandler Spannungsmessungen
Reset Taster
Watermark Sens + Imp.wandler
PINOUT SPANNUNGSVERSORGUNG SOLAR
D13 -> M1
Sensor Module
ANZEIGE LEDS
Bootloader/Code Upload
USB_Volt
Test Points
D12 -> M0
Impedanzwandler A1 A2
BME280 Stecker

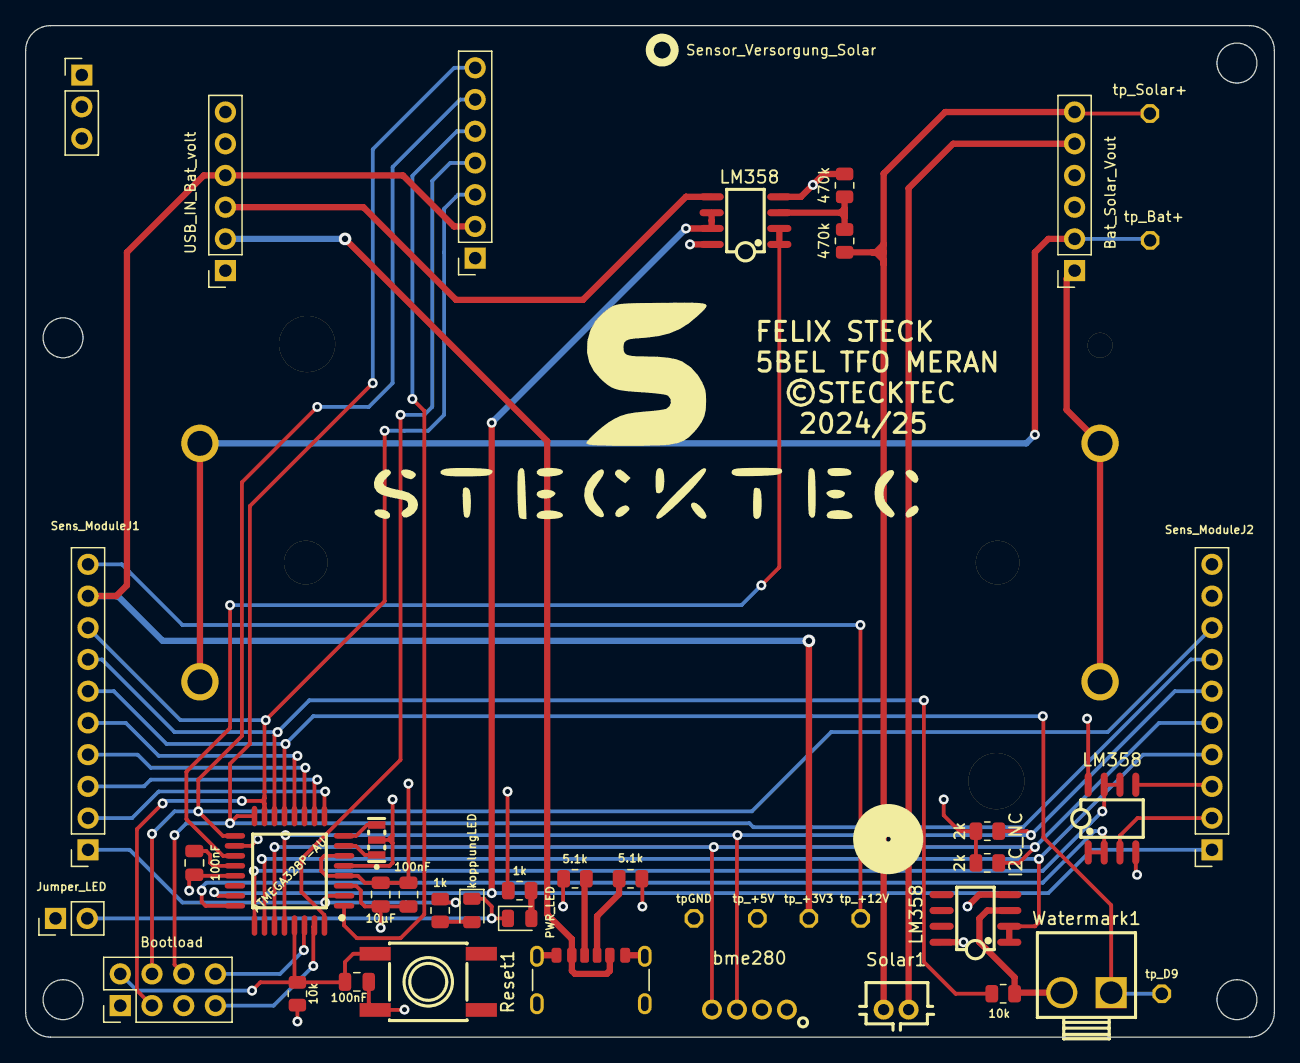
[picture p94: board Sensor_Baseplatine_ohneUSB.kicad_pcb from above]

Board: 4 copper layers, 100.0 x 81.0 mm, 42 parts (1 on the bottom side), 44 nets.
