06Felix06/Stecktec-EIC_GitHub/hardware/archiv_V1/Solarversorgung_V1/Sensor_Versorgung_Solar.kicad_pcb

## KiCad design hardware/archiv_V1/Solarversorgung_V1/Sensor_Versorgung_Solar.kicad_pcb (2026-11-07, an earlier design)

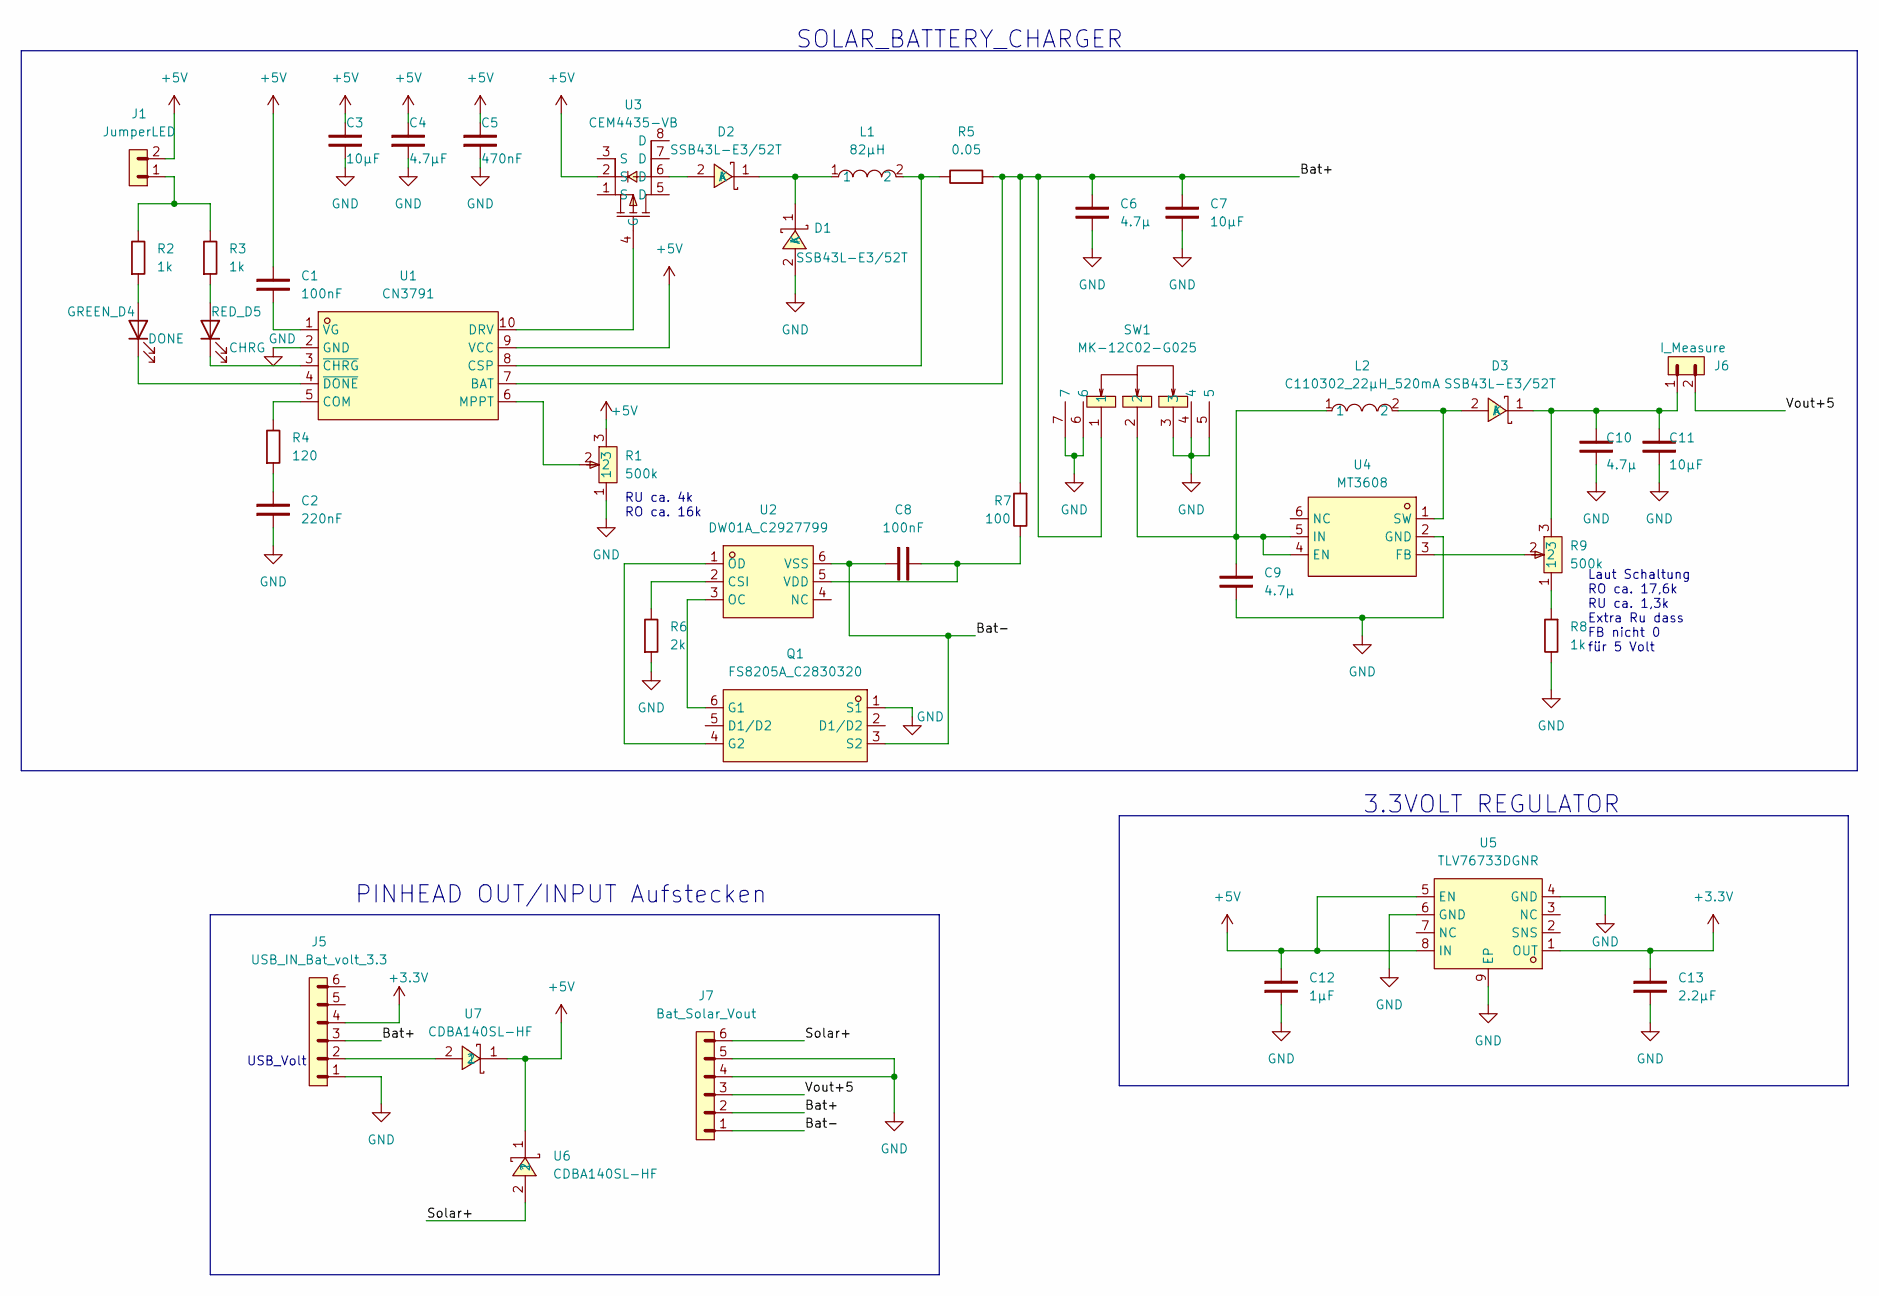
[picture p95: schematic Sensor_Versorgung_Solar.kicad_sch]

Parts:
C1, C8: 100nF; C_0805_2012Metric
C2: 220nF; C_0805_2012Metric
C3, C7, C11: 10µF; C_0805_2012Metric
C4: 4.7µF; C_0805_2012Metric
C5: 470nF; C_0805_2012Metric
C6, C9, C10: 4.7µ; C_0805_2012Metric
C12: 1µF; C_0805_2012Metric
C13: 2.2µF; C_0805_2012Metric
D1, D2, D3: SSB43L-E3/52T; SMB_L4.6-W3.6-LS5.3-RD; LCSC Part C222519
GREEN_D4: DONE; LED_0805_2012Metric
J1: JumperLED; PinHeader_1x02_P2.54mm_Vertical
J5: USB_IN_Bat_volt_3.3; PinHeader_1x06_P2.54mm_Vertical
J6: I_Measure; PinHeader_1x02_P2.54mm_Vertical
J7: Bat_Solar_Vout; PinHeader_1x06_P2.54mm_Vertical
L1: 82µH; IND-SMD_L3.5-W2.9_FHW1210IF820JST; LCSC Part C394099
L2: C110302_22µH_520mA; IND-SMD_L3.0-W3.0_LQH3NPN; LCSC Part C110302
Q1: FS8205A_C2830320; SOT-23-6_L2.9-W1.6-P0.95-LS2.8-BR; LCSC Part C2830320
R1, R9: 500k; RES-ADJ-SMD_VG039NCH; LCSC Part C128558
R2, R3, R8: 1k; R_0805_2012Metric
R4: 120; R_0805_2012Metric
R5: 0.05; R_0805_2012Metric
R6: 2k; R_0805_2012Metric
R7: 100; R_0805_2012Metric
RED_D5: CHRG; LED_0805_2012Metric
SW1: MK-12C02-G025; SW-SMD_MK-12C02-G025; LCSC Part C778186
U1: CN3791; SSOP-10_L4.9-W3.9-P1.00-LS6.0-BL; LCSC Part C154992
U2: DW01A_C2927799; SOT-23-6_L2.9-W1.6-P0.95-LS2.8-BL; LCSC Part C2927799
U3: CEM4435-VB; SOIC-8_L4.9-W3.9-P1.27-LS6.0-BL; LCSC Part C5137442
U4: MT3608; SOT-23-6_L2.9-W1.6-P0.95-LS2.8-BL; LCSC Part C84817
U5: TLV76733DGNR; MSOP-8_L3.0-W3.0-P0.65-LS4.9-BL-EP-1; LCSC Part C2873382
U6, U7: CDBA140SL-HF; DO-214AC_L4.3-W2.7-LS5.3-RD; LCSC Part C3012747

Connections:
+3.3V: C13.2, J5.4, U5.1 (OUT)
+5V: C1.2, C3.1, C4.2, C5.2, C12.2, J1.2, R1.3, U1.9 (VCC), U3.2 (S), U5.5 (EN), U5.8 (IN), U6.1, U7.1
/Bat+: C6.1, C7.1, J5.3, J7.2, R5.1, R7.1, SW1.1, U1.7 (BAT)
/Bat-: C8.1, J7.1, Q1.3 (S2), U2.6 (VSS)
/Solar+: J7.6, U6.2
/Vout+5: J6.2, J7.3
GND: C2.1, C3.2, C4.1, C5.1, C6.2, C7.2, C9.2, C10.2, C11.2, C12.1, C13.1, D1.2 (A), J5.1, J7.4, J7.5, Q1.1 (S1), R1.1, R6.1, R8.2, SW1.3, SW1.4, SW1.5, SW1.6, SW1.7, U1.2 (GND), U4.2 (GND), U5.4 (GND), U5.6 (GND), U5.9 (EP)
unnamed: C2.2, R4.1
unnamed: D1.1 (K), D2.1 (K), L1.1
unnamed: D2.2 (A), U3.6 (D)
unnamed: D3.2 (A), L2.2, U4.1 (SW)
unnamed: C10.1, C11.1, D3.1 (K), J6.1, R9.3
unnamed: GREEN_D4.2 (A), R2.1
unnamed: GREEN_D4.1 (K), U1.4 (~DONE)
unnamed: J1.1, R2.2, R3.2
unnamed: J5.2, U7.2
unnamed: Q1.6 (G1), U2.3 (OC)
unnamed: Q1.4 (G2), U2.1 (OD)
unnamed: R8.1, R9.1
unnamed: R3.1, RED_D5.2 (A)
unnamed: RED_D5.1 (K), U1.3 (~CHRG)
unnamed: R4.2, U1.5 (COM)
unnamed: L1.2, R5.2, U1.8 (CSP)
unnamed: U1.10 (DRV), U3.4 (G)
unnamed: R1.2, U1.6 (MPPT)
unnamed: C1.1, U1.1 (VG)
unnamed: R6.2, U2.2 (CSI)
unnamed: C8.2, R7.2, U2.5 (VDD)
unnamed: C9.1, L2.1, SW1.2, U4.4 (EN), U4.5 (IN)
unnamed: R9.2, U4.3 (FB)

Notes on the sheet:
PINHEAD OUT/INPUT Aufstecken
RU ca. 4k RO ca. 16k
SOLAR_BATTERY_CHARGER
Laut Schaltung RO ca. 17,6k RU ca. 1,3k Extra Ru dass FB nicht 0 für 5 Volt
3.3VOLT REGULATOR
USB_Volt

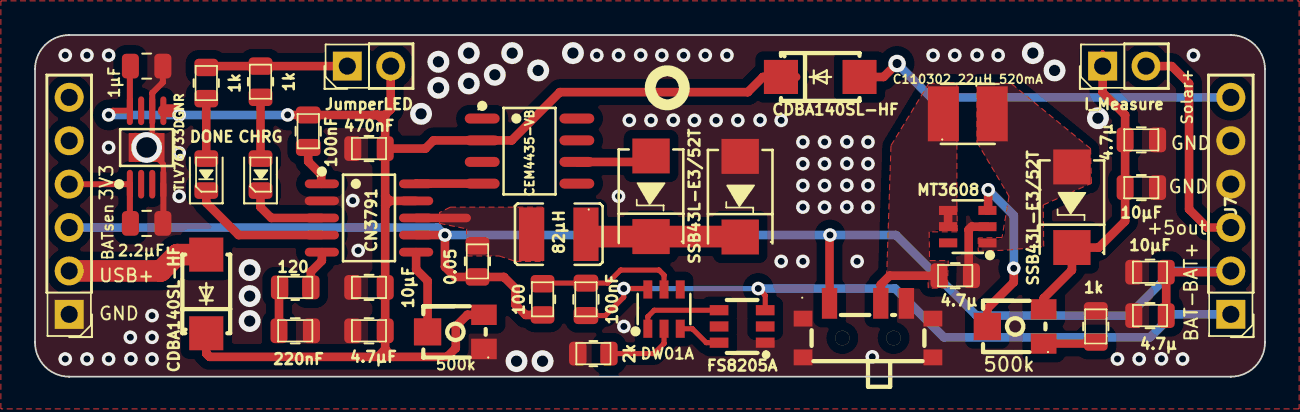
[picture p96: board Sensor_Versorgung_Solar.kicad_pcb from above]

Board: 2 copper layers, 72.0 x 20.0 mm, 42 parts (0 on the bottom side), 30 nets.
