06Felix06/Stecktec-EIC_GitHub/hardware/03_Magnetventilsteuerung/Sensor_Magnetventilsteuerung.kicad_pcb

## KiCad design hardware/03_Magnetventilsteuerung/Sensor_Magnetventilsteuerung.kicad_pcb (2026-11-07)

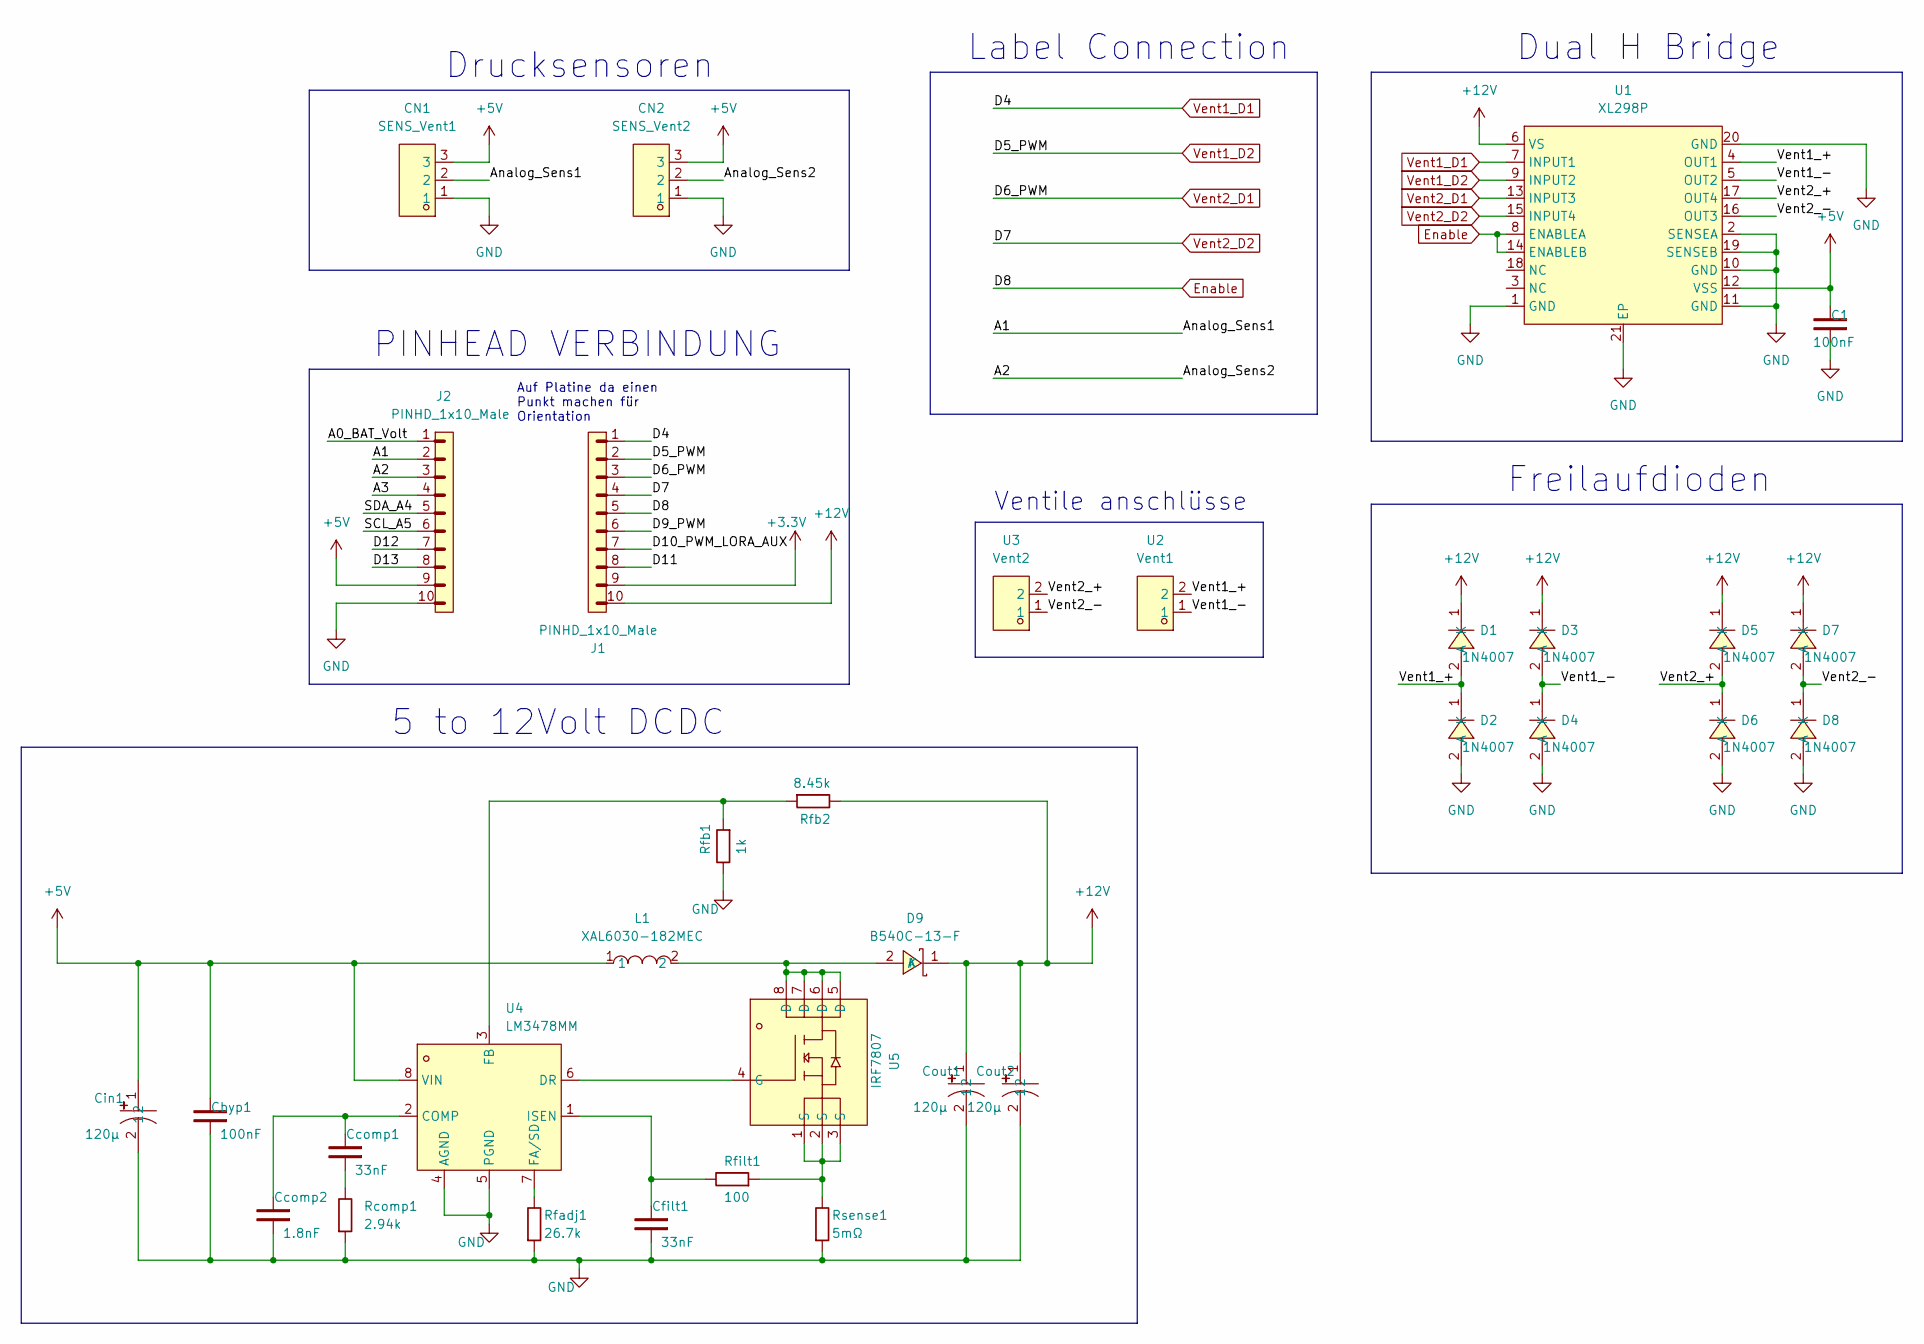
[picture p97: schematic Sensor_Magnetventilsteuerung.kicad_sch, Magnetventilsteuerung]

Parts:
C1: 100nF; C_0805_2012Metric
CN1: SENS_Vent1; CONN-TH_B3B-PH-K-S; LCSC Part C131339
CN2: SENS_Vent2; CONN-TH_B3B-PH-K-S; LCSC Part C131339
Cbyp1: 100nF; C_0805_2012Metric
Ccomp1: 33nF; C_0805_2012Metric
Ccomp2: 1.8nF; C_0805_2012Metric
Cfilt1: 33nF; C_0805_2012Metric
Cin1: 120µ; CAP-TH_BD6.3-P2.50-D1.0-FD; LCSC Part C442997
Cout1, Cout2: 120µ; CAP-TH_BD6.3-P2.50-D1.0-FD; LCSC Part C442997
D1, D2, D3, D4, D5, D6, D7, D8: 1N4007; SMA_L4.3-W2.5-LS5.0-RD; LCSC Part C727081
D9: B540C-13-F; SMC_L7.1-W6.2-LS8.1-RD; LCSC Part C72264
J1, J2: PINHD_1x10_Male; PinHeader_1x10_P2.54mm_Vertical
L1: XAL6030-182MEC; IND-SMD_L6.6-W6.4; LCSC Part C19191693
Rcomp1: 2.94k; R_0805_2012Metric
Rfadj1: 26.7k; R_0805_2012Metric
Rfb1: 1k; R_0805_2012Metric
Rfb2: 8.45k; R_0805_2012Metric
Rfilt1: 100; R_0805_2012Metric
Rsense1: 5mΩ; R_0805_2012Metric
U1: XL298P; HSOP-20_L15.9-W11.0-P1.27-LS14.2-BL-EP; LCSC Part C17179540
U2: Vent1; CONN-TH_2P-P5.00_MX127-5.0-02P-GN01-CU-Y-A; LCSC Part C5188440
U3: Vent2; CONN-TH_2P-P5.00_MX127-5.0-02P-GN01-CU-Y-A; LCSC Part C5188440
U4: LM3478MM; VSSOP-8_L3.0-W3.0-P0.65-LS5.0-BL; LCSC Part C9404
U5: IRF7807; SOP-8_L4.9-W3.9-P1.27-LS6.0-BL; LCSC Part C5350865

Connections:
+3.3V: J1.9
+5V: C1.1, CN1.3, CN2.3, Cbyp1.1, Cin1.1, J2.9, L1.1, U1.12 (VSS), U4.8 (VIN)
+12V: Cout1.1, Cout2.1, D1.1 (K), D3.1 (K), D5.1 (K), D7.1 (K), D9.1 (K), J1.10, Rfb2.2, U1.6 (VS)
/A0_BAT_Volt: J2.1
/A1: CN1.2, J2.2
/A2: CN2.2, J2.3
/A3: J2.4
/D9_PWM: J1.6
/D10_PWM_LORA_AUX: J1.7
/D11: J1.8
/D12: J2.7
/D13: J2.8
/SCL_A5: J2.6
/SDA_A4: J2.5
/Vent1_+: D1.2 (A), D2.1 (K), U1.4 (OUT1), U2.2
/Vent1_-: D3.2 (A), D4.1 (K), U1.5 (OUT2), U2.1
/Vent2_+: D5.2 (A), D6.1 (K), U1.17 (OUT4), U3.2
/Vent2_-: D7.2 (A), D8.1 (K), U1.16 (OUT3), U3.1
Enable: J1.5, U1.8 (ENABLEA), U1.14 (ENABLEB)
GND: C1.2, CN1.1, CN2.1, Cbyp1.2, Ccomp2.2, Cfilt1.2, Cin1.2, Cout1.2, Cout2.2, D2.2 (A), D4.2 (A), D6.2 (A), D8.2 (A), J2.10, Rcomp1.1, Rfadj1.1, Rfb1.2, Rsense1.1, U1.1 (GND), U1.2 (SENSEA), U1.10 (GND), U1.11 (GND), U1.19 (SENSEB), U1.20 (GND), U1.21 (EP), U4.4 (AGND), U4.5 (PGND)
unnamed: Ccomp1.2, Rcomp1.2
unnamed: D9.2 (A), L1.2, U5.5 (D), U5.6 (D), U5.7 (D), U5.8 (D)
unnamed: Rfilt1.1, Rsense1.2, U5.1 (S), U5.2 (S), U5.3 (S)
unnamed: Ccomp1.1, Ccomp2.1, U4.2 (COMP)
unnamed: U4.6 (DR), U5.4 (G)
unnamed: Rfadj1.2, U4.7 (FA/SD)
unnamed: Rfb1.1, Rfb2.1, U4.3 (FB)
unnamed: Cfilt1.1, Rfilt1.2, U4.1 (ISEN)
Vent1_D1: J1.1, U1.7 (INPUT1)
Vent1_D2: J1.2, U1.9 (INPUT2)
Vent2_D1: J1.3, U1.13 (INPUT3)
Vent2_D2: J1.4, U1.15 (INPUT4)

Notes on the sheet:
5 to 12Volt DCDC
Auf Platine da einen Punkt machen für Orientation
Drucksensoren
Ventile anschlüsse
Label Connection
Freilaufdioden
PINHEAD VERBINDUNG
Dual H Bridge

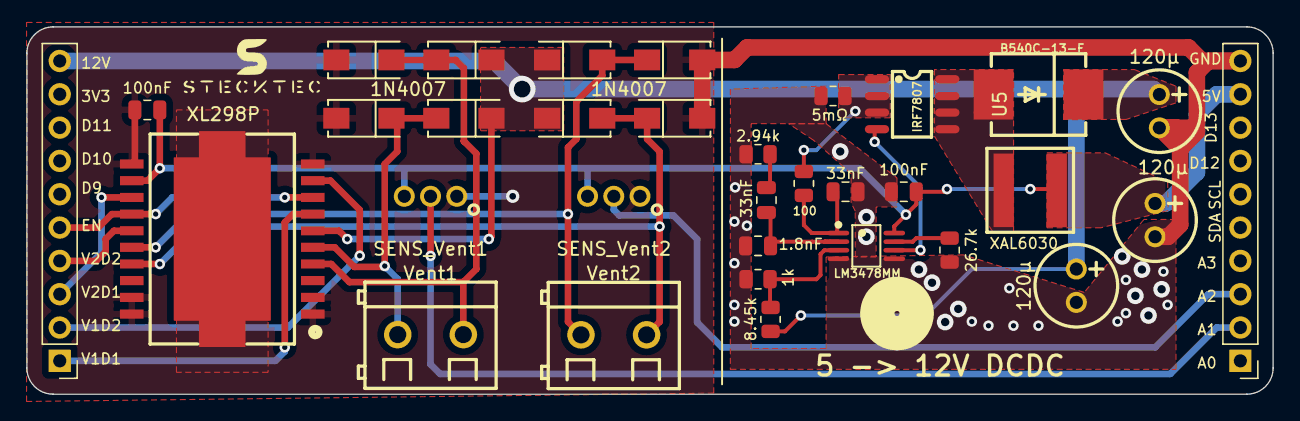
[picture p98: board Sensor_Magnetventilsteuerung.kicad_pcb from above]

Board: 2 copper layers, 95.0 x 28.0 mm, 33 parts (0 on the bottom side), 22 nets.
