06Felix06/Stecktec-EIC_GitHub/(notices)

Notices in the files:
hardware/03_Magnetventilsteuerung/Sensor_Magnetventilsteuerung.kicad_pcb:
©️STECKTEC
